enriquewph/Impresora-Braille/Documentacion/Imagenes/IMG_20190517_113228.jpg

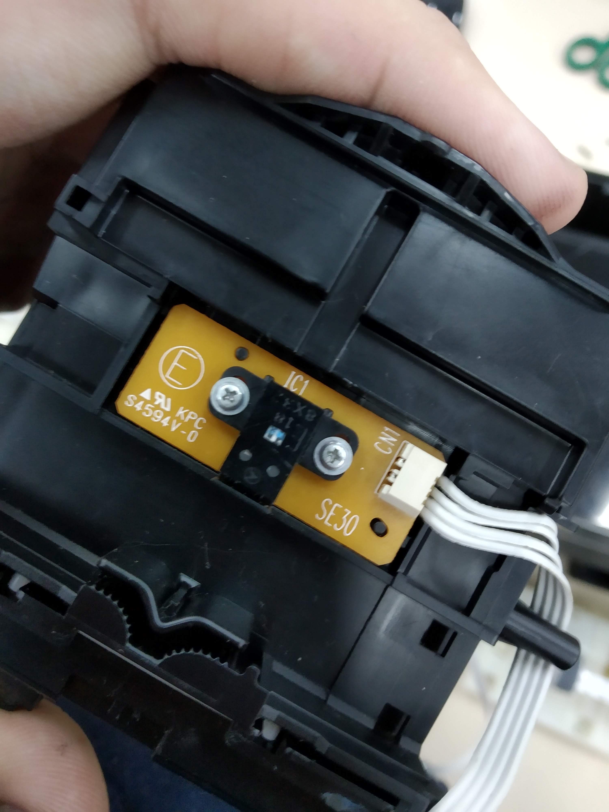
Documentacion/Imagenes/IMG_20190517_113228.jpg
