enriquewph/Impresora-Braille/Documentacion/Imagenes/IMG_20190517_133737.jpg

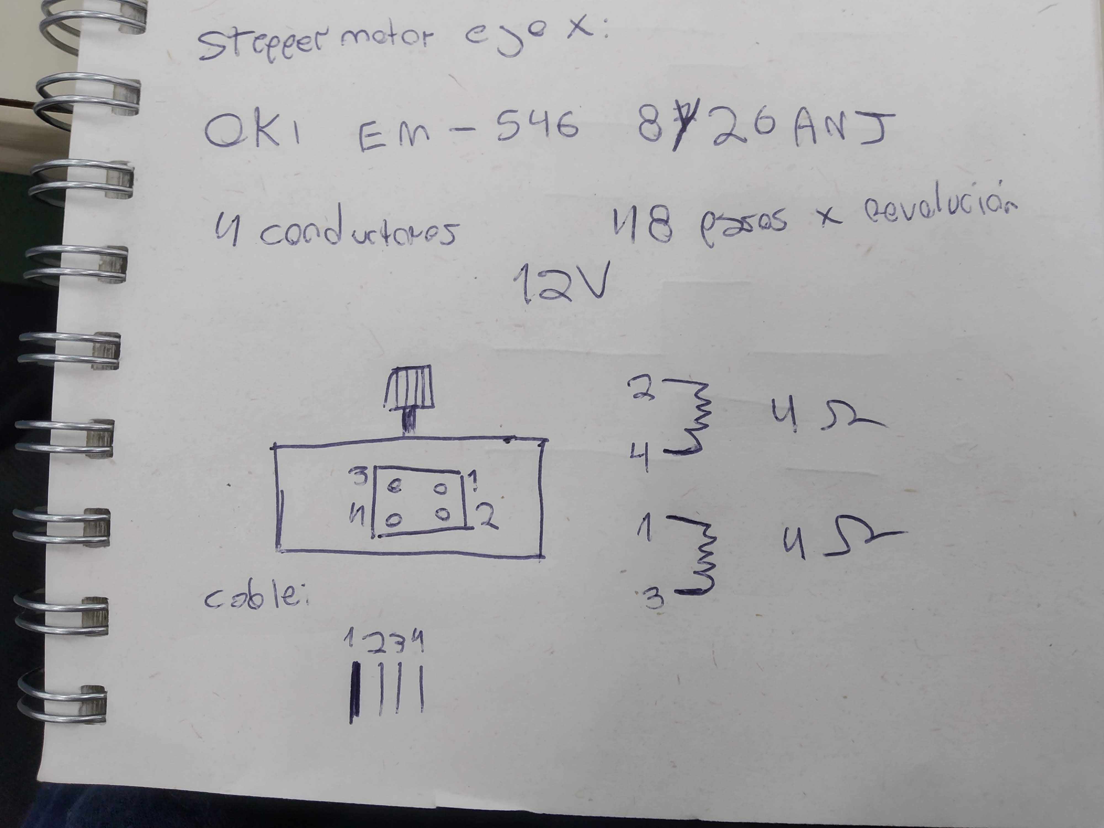
Documentacion/Imagenes/IMG_20190517_133737.jpg
