enriquewph/Impresora-Braille/Documentacion/Jerarquias Programa.docx

Comunicación (WIFI, USB, BT, SD, etc)
Procesamiento de comandos
Instrucciones para ejecucion de movimientos
Interfaz de motores, sensores y actuadores
Arduino
RTOS

1
Edicion de texto no - braille
Vista previa de traducción
2
Traduccion definitiva
Edicion del texto traducido.
3
Generar documento tipo PDF.
Procesar PDF, generar matriz de puntos.
4
Vista previa del documento
Conexion e impresión
