enriquewph/Impresora-Braille/Electronica/revision_fuentesw.pdf

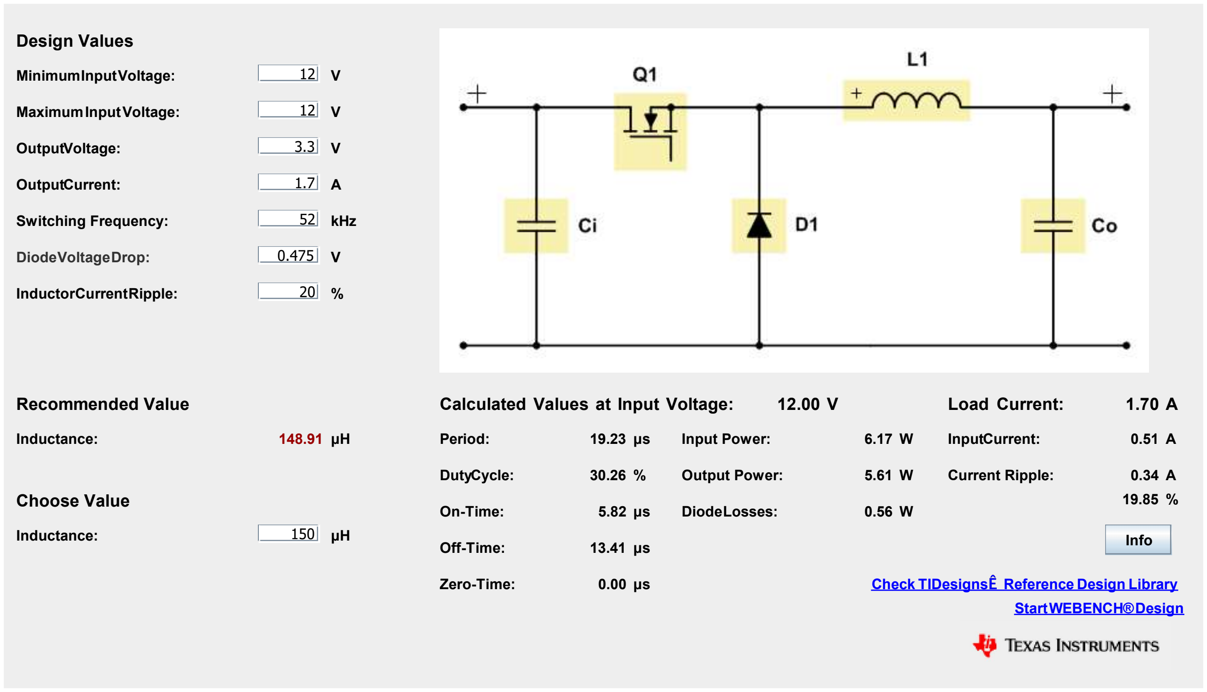
[picture p3: figure]
Load Current:; Start WEBENCH® Design; Info; Current Ripple:; Period:; InputCurrent:; Calculated Values at Input Voltage:; 5.82 Diode Losses:; Input Power:; DutyCycle:; Output Power:; Zero-Time:; Off-Time:; On-Time:; Design Values; Diode Voltage Drop:; Choose Value; Inductance:; Recommended Value; 52 kHz; Inductor Current Ripple:; Switching Frequency:; OutputCurrent:; OutputVoltage:; Maximum Input Voltage:; Minimum Input Voltage:

## Check TIDesigns Reference Design Library

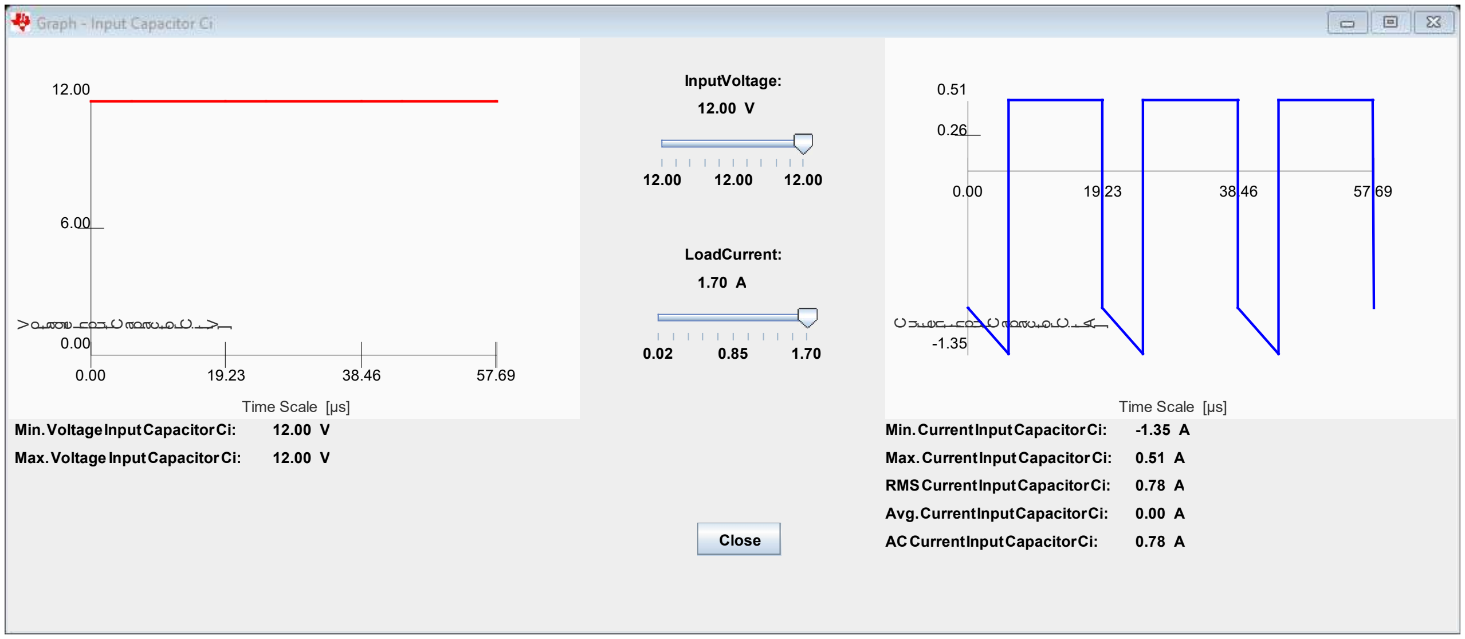
[picture p4: figure]
AC Current Input Capacitor Ci:; Avg. Current Input Capacitor Ci:; RMS Current Input Capacitor Ci:; Max. Current Input Capacitor Ci:; Min. Current Input Capacitor Ci:; Time Scale [μs] C u r; ito; Close; Max. Voltage Input Capacitor Ci:; Min. Voltage Input Capacitor Ci:; LoadCurrent:; InputVoltage:; Time Scale [μs] V o; lta

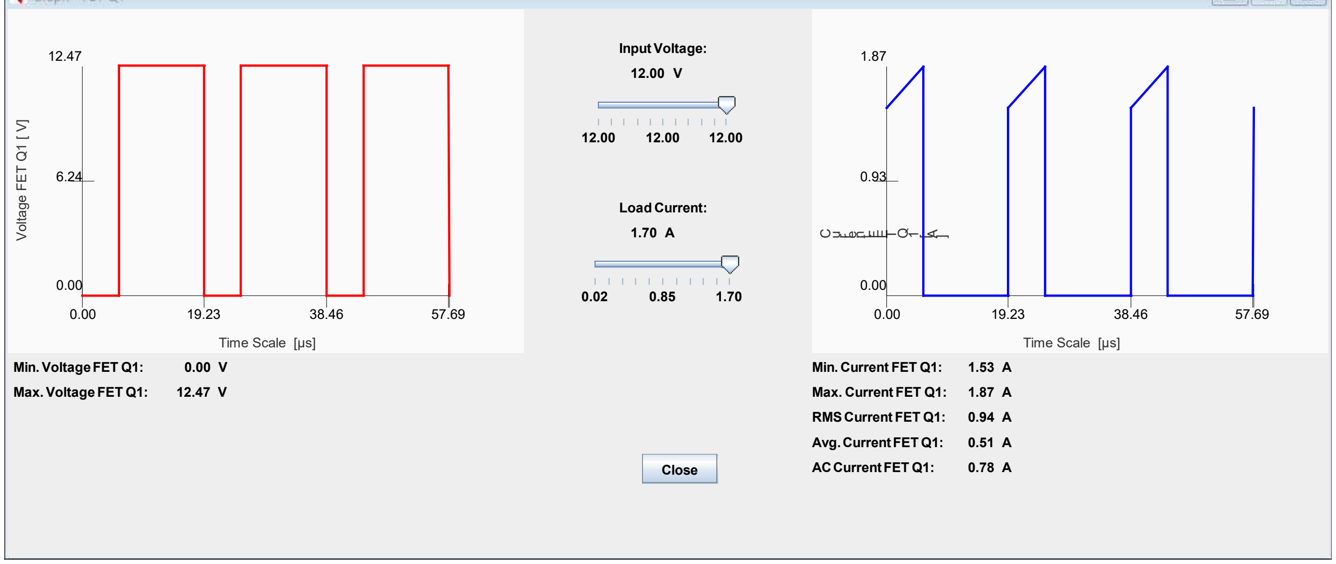
[picture p5: figure]
AC Current FET Q1:; Avg. Current FET Q1:; RMS Current FET Q1:; Max. Current FET Q1:; Min. Current FET Q1:; Time Scale [μs] C u r; tFE; Close; Max. Voltage FET Q1:; Min. Voltage FET Q1:; Load Current:; Input Voltage:; Time Scale [μs] Voltage FET Q¹ [ V]

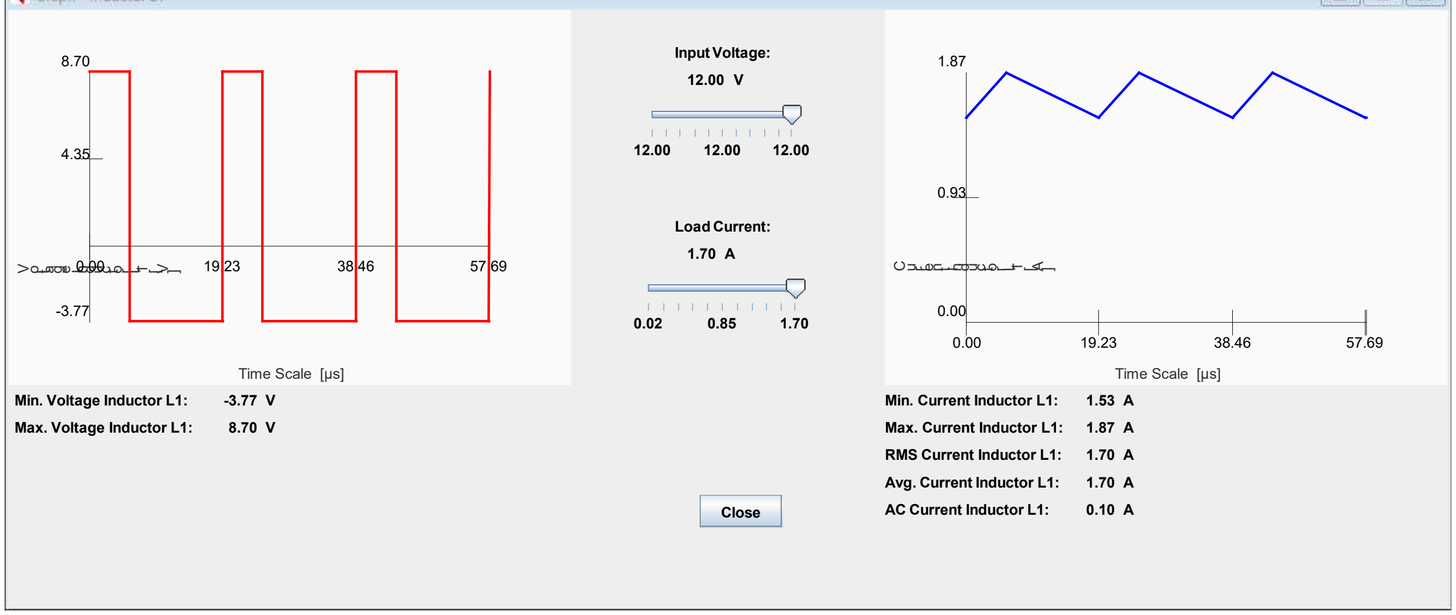
[picture p6: figure]
AC Current Inductor L1:; Avg. Current Inductor L1:; RMS Current Inductor L1:; Max. Current Inductor L1:; Min. Current Inductor L1:; Time Scale [μs] C u r; Close; Max. Voltage Inductor L1:; Min. Voltage Inductor L1:; Load Current:; Input Voltage:; Time Scale [μs] V o; lta

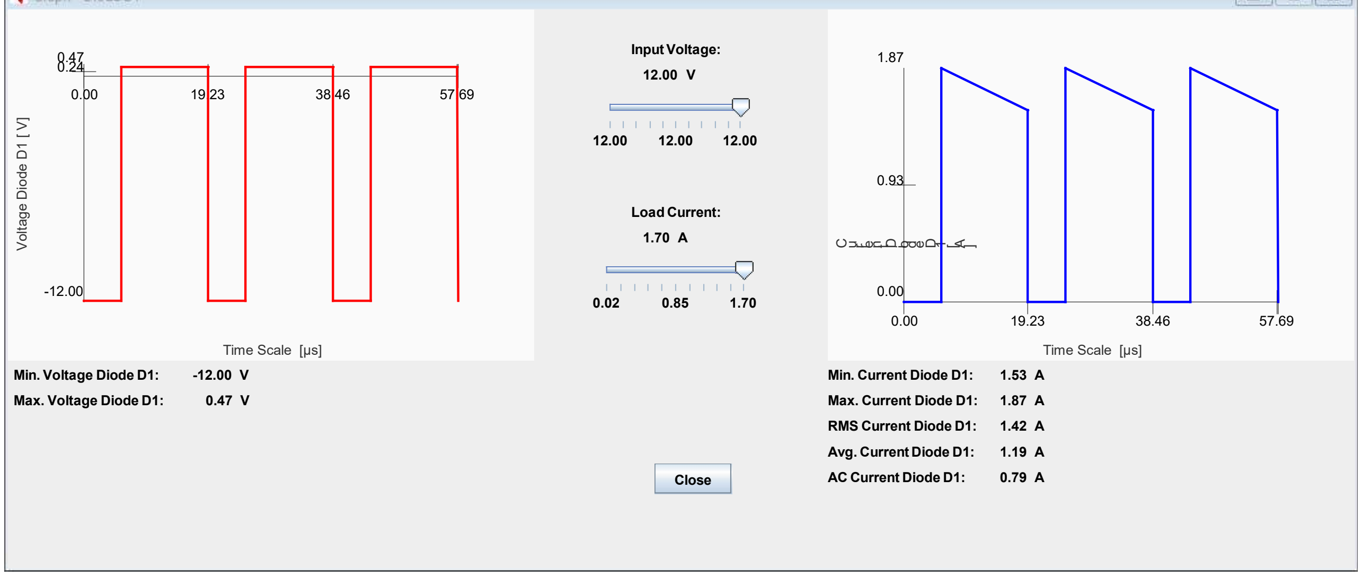
[picture p7: figure]
AC Current Diode D1:; Avg. Current Diode D1:; RMS Current Diode D1:; Max. Current Diode D1:; Min. Current Diode D1:; Time Scale [μs] C u r; Close; Max. Voltage Diode D1:; Min. Voltage Diode D1:; Load Current:; Input Voltage:; Time Scale [μs] Voltage Diode D¹ [ V]

### 97.43 mA

-168.76 mA
168.76 mA

### 0.00 mA

### 97.43 mA

AC Current Output Capacitor Co:

Avg. Current Output Capacitor Co:

RMS Current Output Capacitor Co:

Max. Current Output Capacitor Co:

Min. Current Output Capacitor Co:

Time Scale [μs] Current Output Capacitor Co [ mA] | 0.00 | 19.23 | 38.46 | 57.69

84.38

168.76

-168.76

Close

### 3.30 V

### 3.30 V

Max. Voltage Output Capacitor Co:

Min. Voltage Output Capacitor Co:

Load Current:
1.70

A

0.02 | 0.85 | 1.70

Input Voltage:
12.00

V

12.00 | 12.00 | 12.00

Time Scale [μs] Voltage Output Capacitor Co [ V]

0.00 | 19.23 | 38.46 | 57.69

1.65

3.30

0.00
