enriquewph/Impresora-Braille/Electronica/links.txt

El desarrollo electronico se hace en EASYEDA. en el siguiente proyecto:
https://easyeda.com/quique18c/impresora-braille-2019
