enriquewph/Impresora-Braille/Documentacion/Diagramas de diseño/Diagrama de diseño.pptx

Diagrama de transición de estados

## Slide 2

Diagrama de Flujos

INICIO

Recibir Hoja
