enriquewph/Impresora-Braille/Documentacion/Diagramas de diseño/casos de uso.pdf

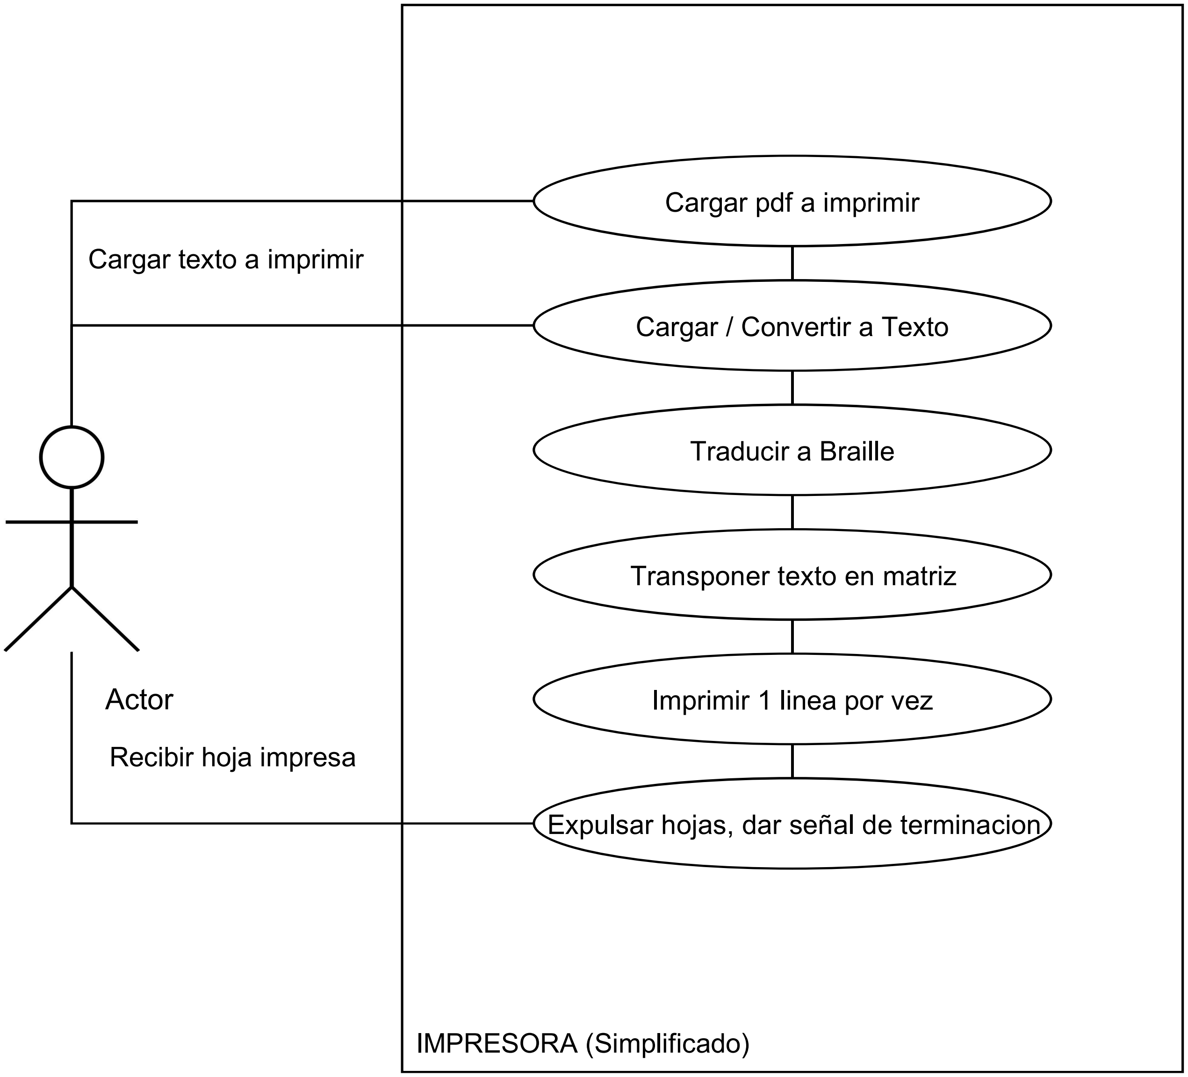
[picture p8: figure]
IMPRESORA (Simplificado); Cargar pdf a imprimir; Cargar / Convertir a Texto; Transponer texto en matriz; Imprimir 1 linea por vez; Traducir a Braille; Actor; Cargar texto a imprimir; Recibir hoja impresa

Expulsar hojas, dar señal de terminacion

# casos de uso
