enriquewph/Impresora-Braille/Documentacion/Diagramas de diseño/diagrama de estados.pdf

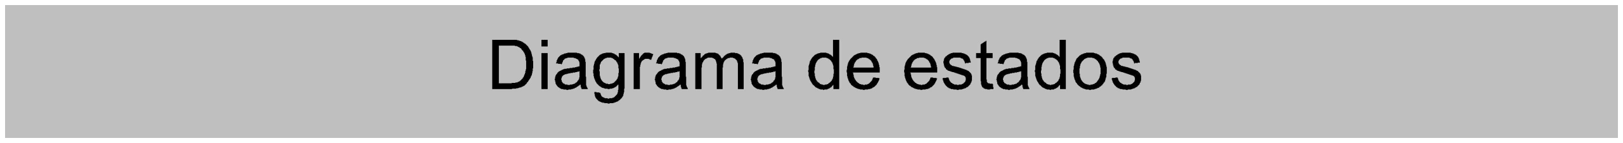
[picture p9: figure]
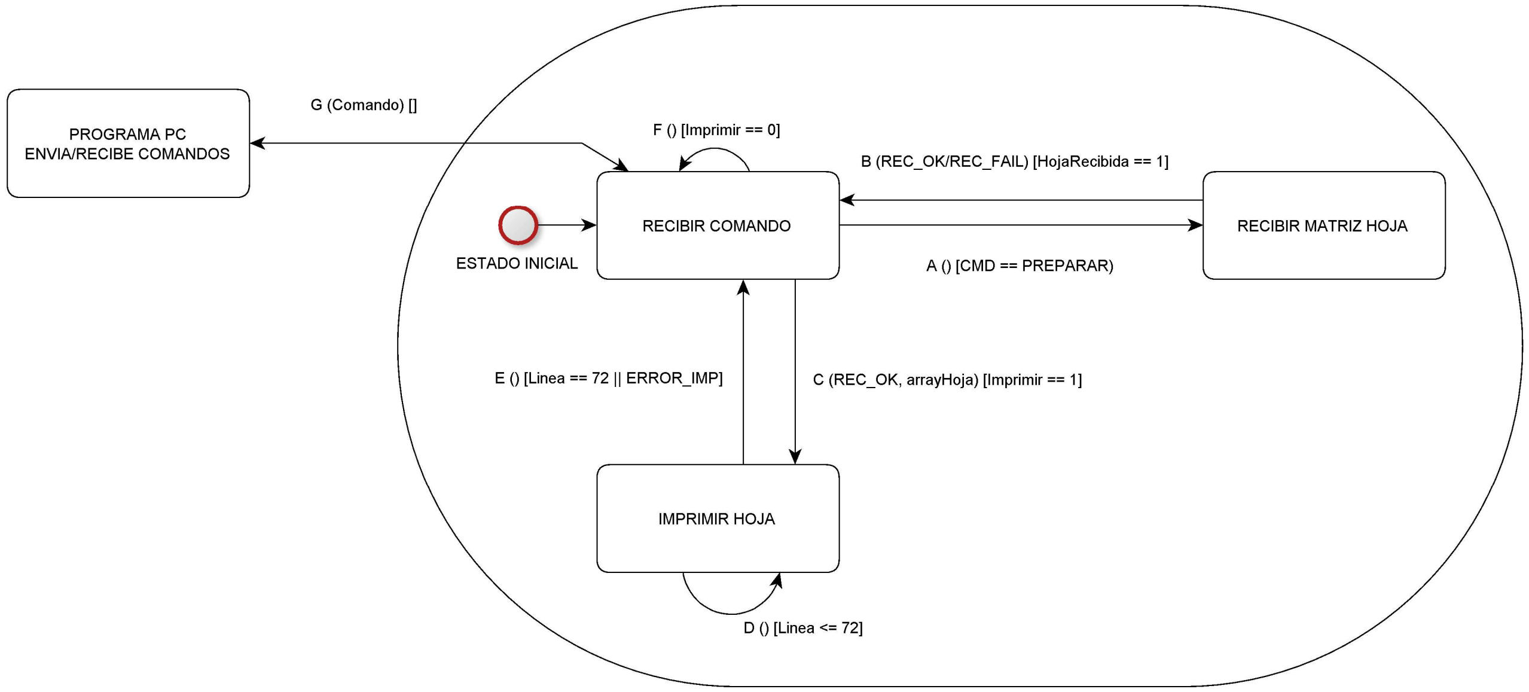
[picture p10: figure]
