enriquewph/Impresora-Braille/Documentacion/Diagramas de diseño/diagrama de flujos.pdf

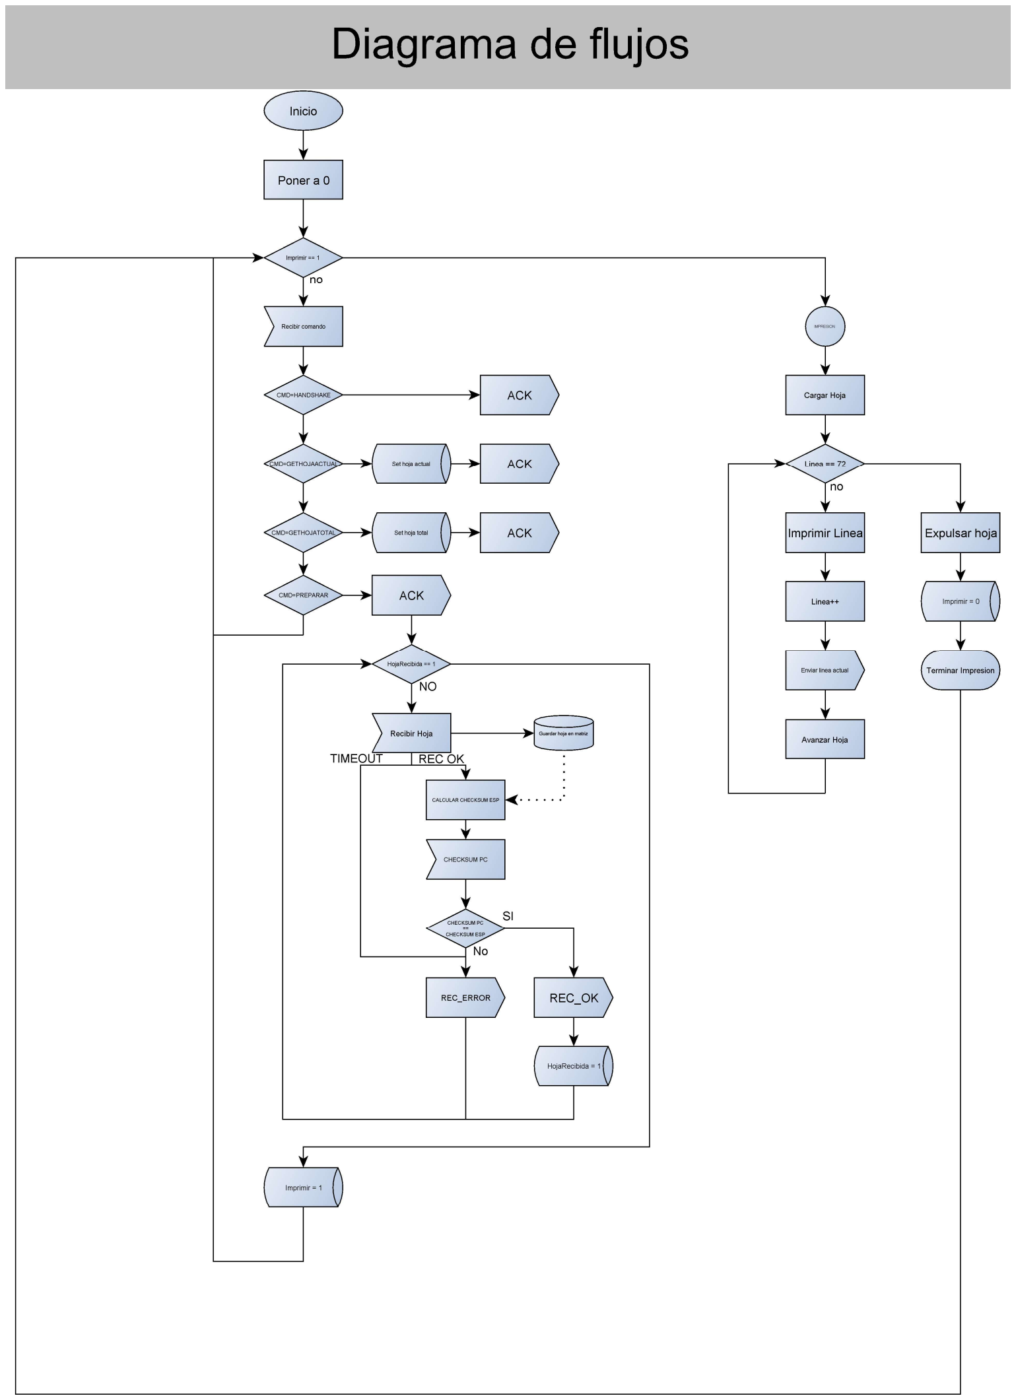
[picture p11: page 1]
