enriquewph/Impresora-Braille/Documentacion/Diseños Graficos/GD Informe/c622d8ba-e4e6-400b-8f1a-ba454055652d.png

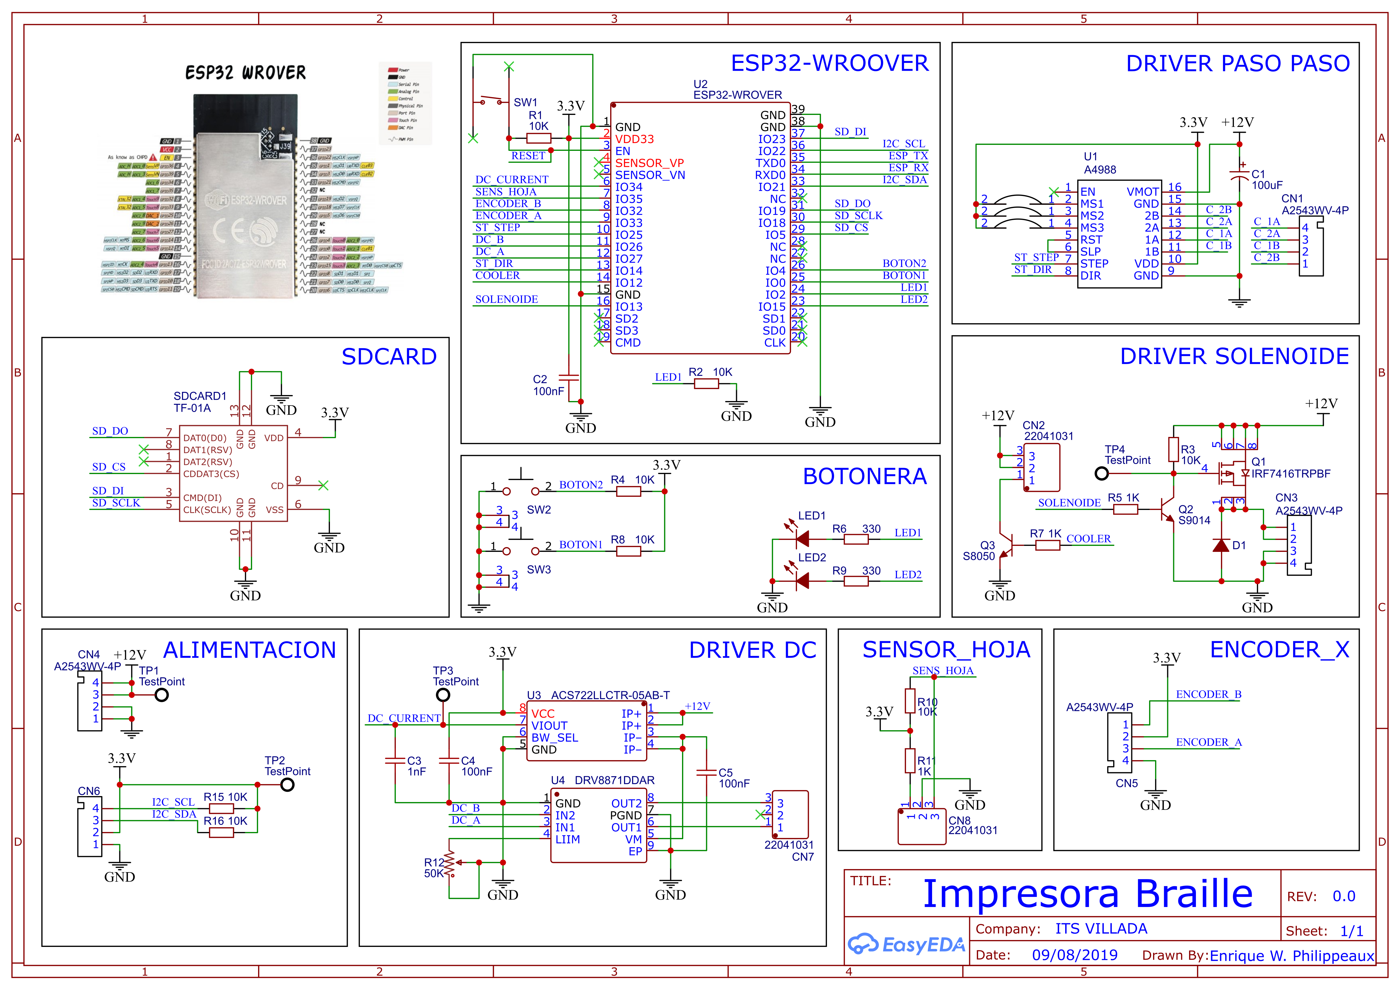
Documentacion/Diseños Graficos/GD Informe/c622d8ba-e4e6-400b-8f1a-ba454055652d.png
