enriquewph/Impresora-Braille/Documentacion/Diseños Graficos/GD Informe/PCB_pcb_20191203164205.png

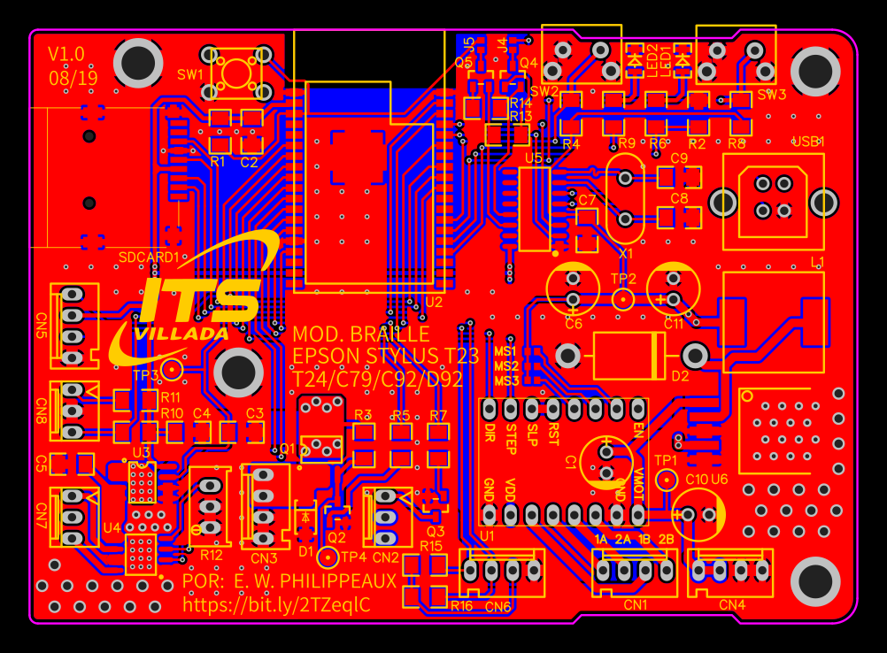
Documentacion/Diseños Graficos/GD Informe/PCB_pcb_20191203164205.png
