enriquewph/Impresora-Braille/Documentacion/Diseños Graficos/GD Informe/PCB_pcb_20191203164240.png

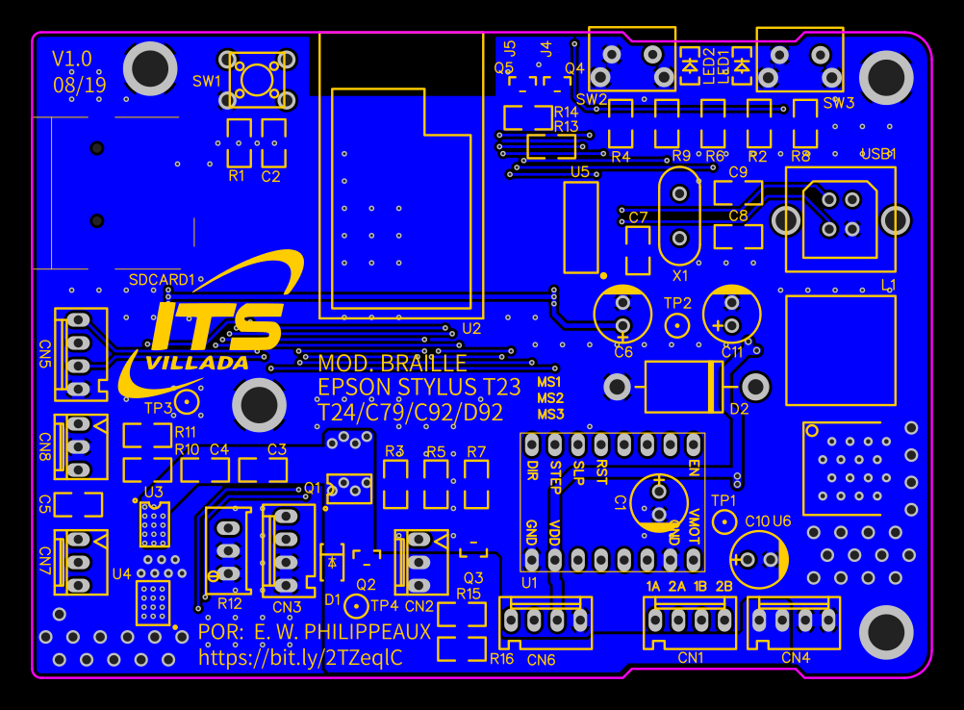
Documentacion/Diseños Graficos/GD Informe/PCB_pcb_20191203164240.png
