enriquewph/Impresora-Braille/Documentacion/Diseños Graficos/GD Informe/Photo View.png

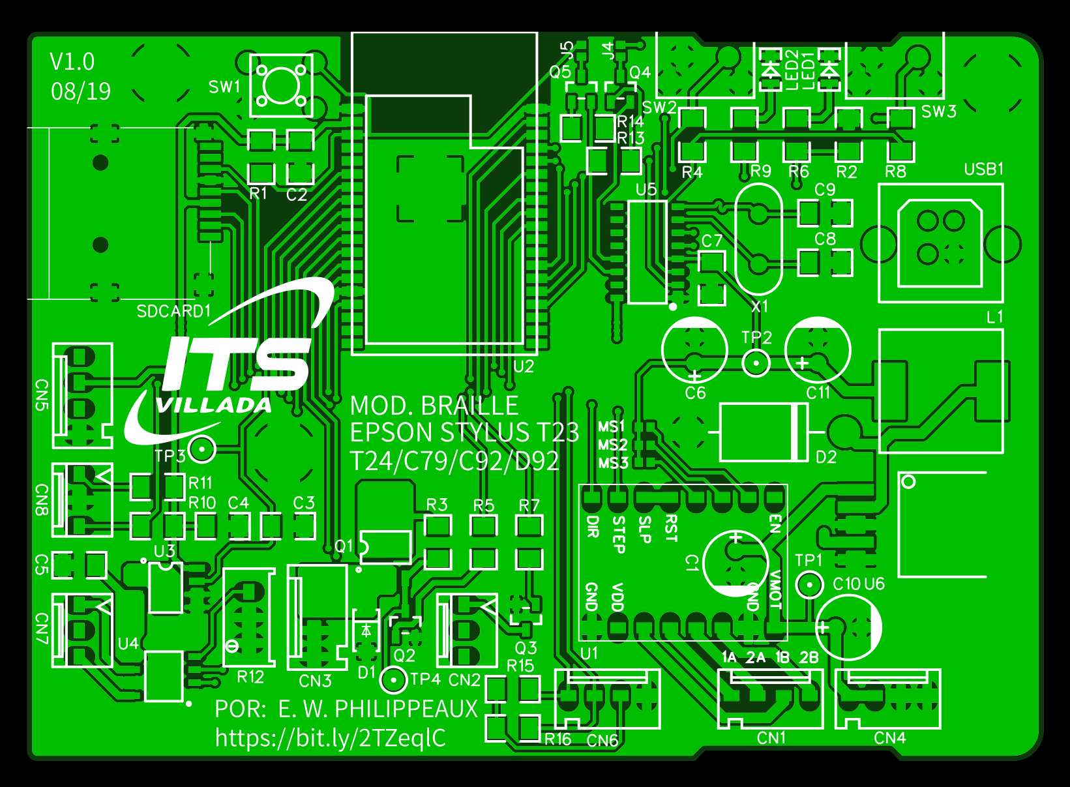
Documentacion/Diseños Graficos/GD Informe/Photo View.png
