enriquewph/Impresora-Braille/Documentacion/Diseños Graficos/GD Informe/rect6.png

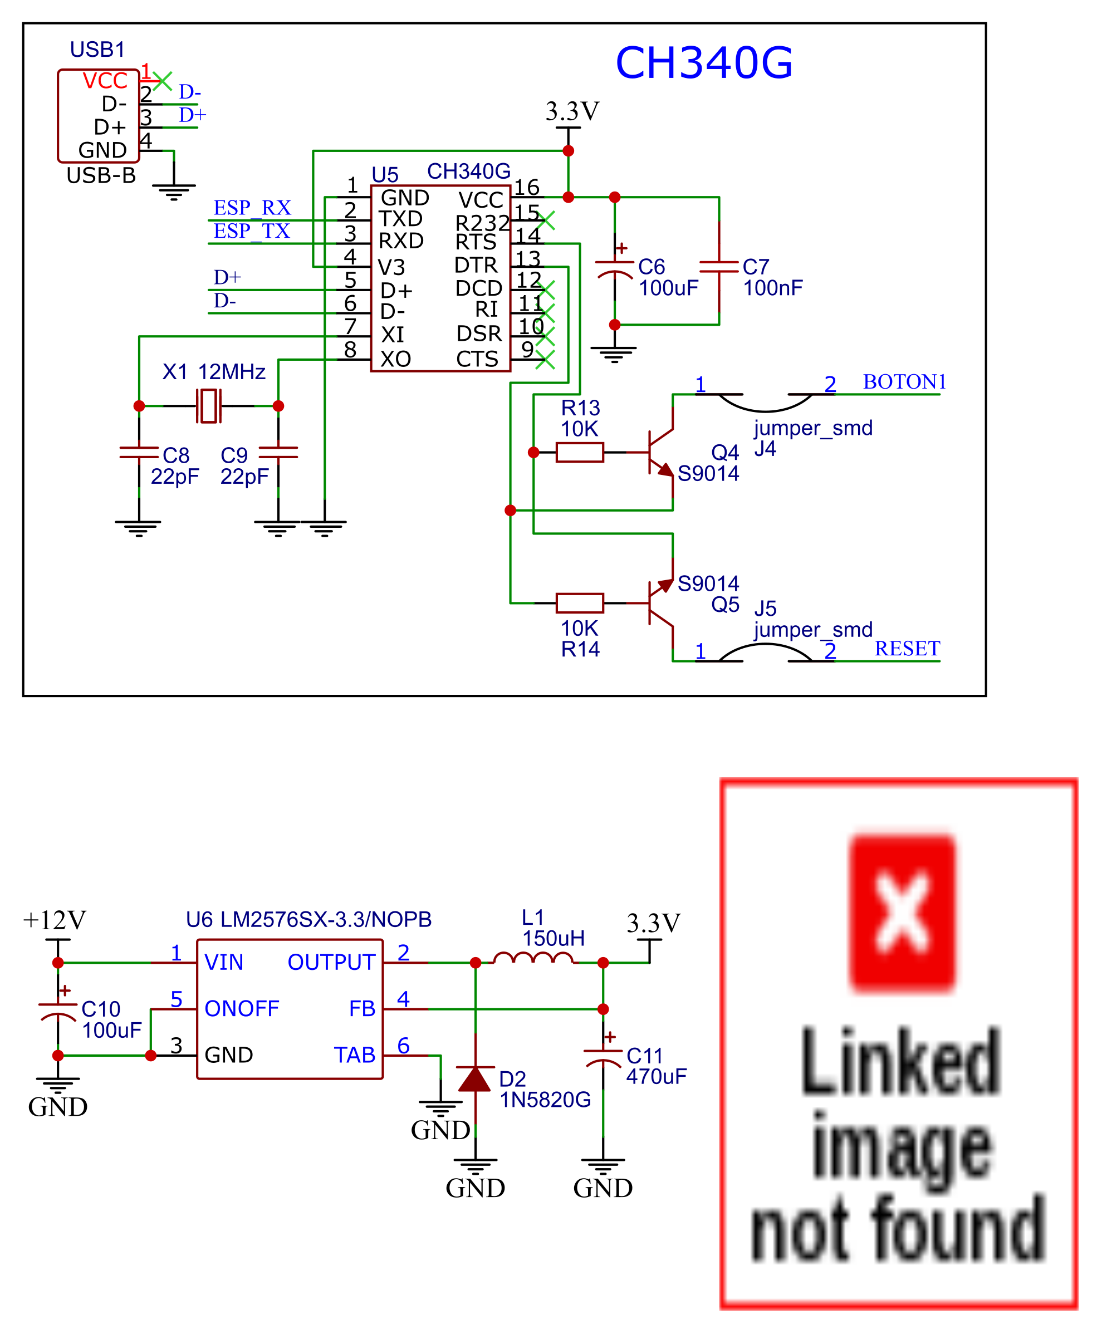
Documentacion/Diseños Graficos/GD Informe/rect6.png
