enriquewph/Impresora-Braille/Documentacion/Diseños Graficos/QR_GITHUB.png

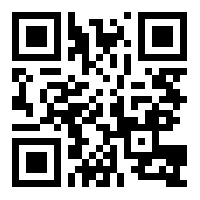
Documentacion/Diseños Graficos/QR_GITHUB.png
