enriquewph/Impresora-Braille/Documentacion/Diseños Graficos/repository-open-graph-template.png

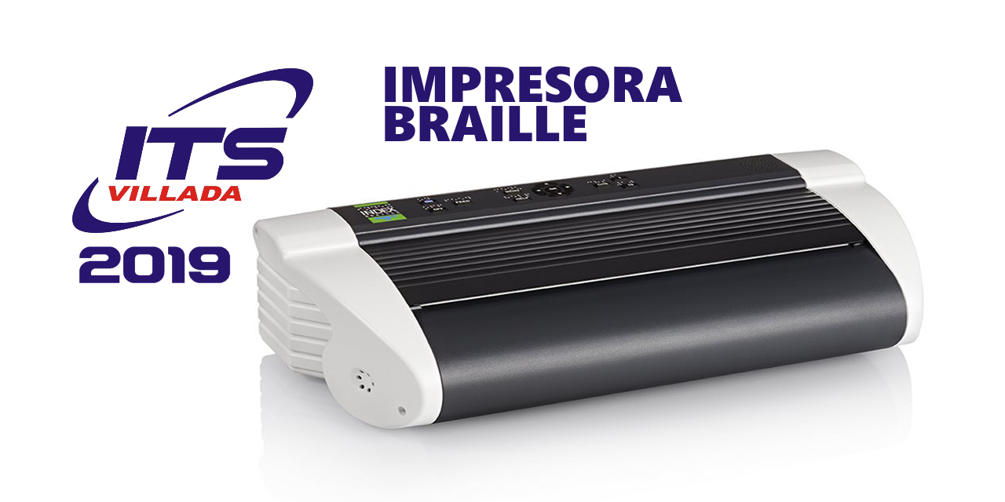
Documentacion/Diseños Graficos/repository-open-graph-template.png
