enriquewph/Impresora-Braille/Documentacion/Diseños Graficos/text4713-w.png

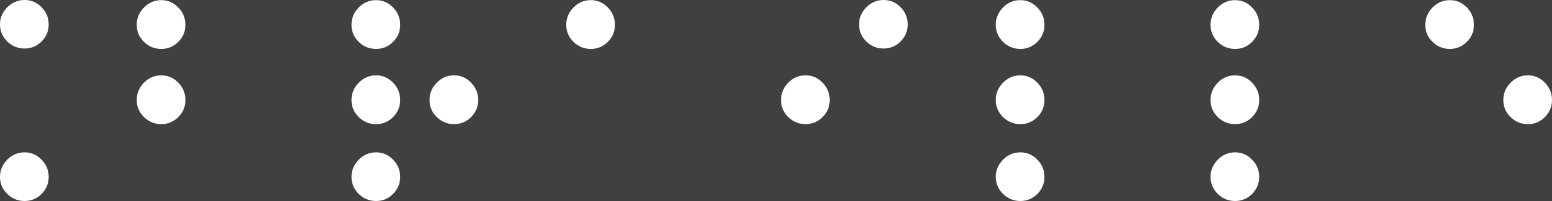
Documentacion/Diseños Graficos/text4713-w.png
