enriquewph/Impresora-Braille/Documentacion/Diseños Graficos/text4713.png

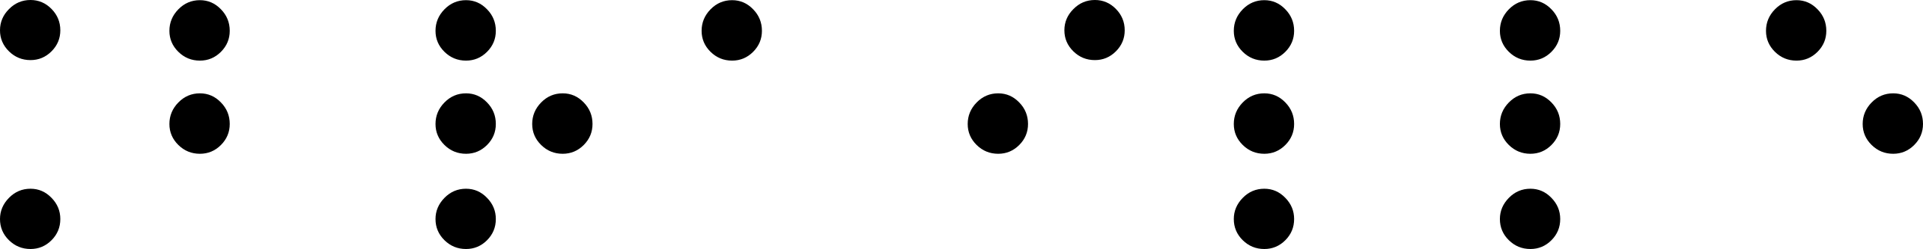
Documentacion/Diseños Graficos/text4713.png
