enriquewph/Impresora-Braille/Documentacion/Documentos Técnicos Signografía Braille/275px-Braille_code_dimensions.jpg

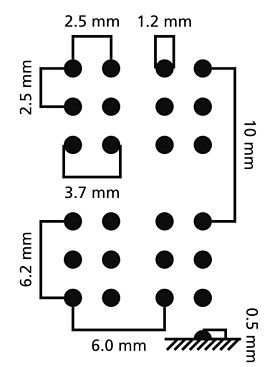
Documentacion/Documentos Técnicos Signografía Braille/275px-Braille_code_dimensions.jpg
