enriquewph/Impresora-Braille/Documentacion/Imagenes/IMG_20190517_100155.jpg

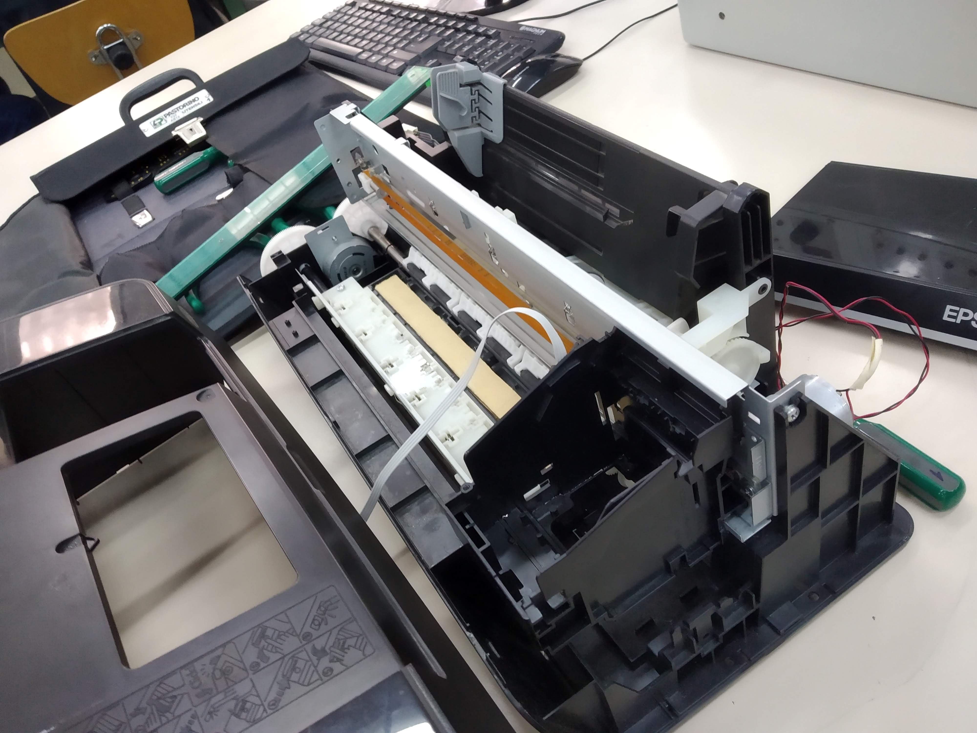
Documentacion/Imagenes/IMG_20190517_100155.jpg
