enriquewph/Impresora-Braille/Documentacion/Imagenes/IMG_20190517_100206.jpg

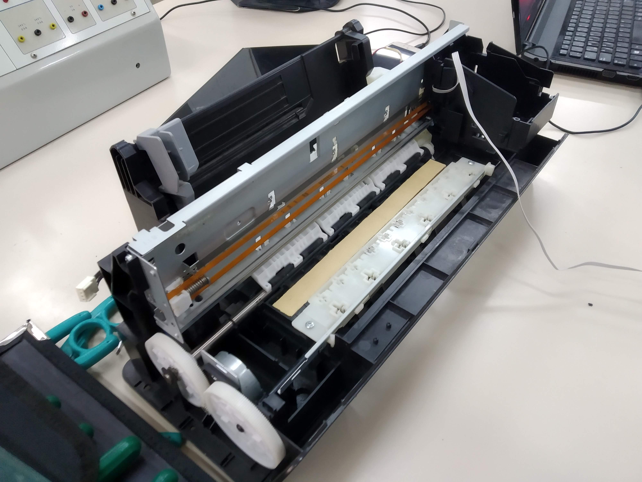
Documentacion/Imagenes/IMG_20190517_100206.jpg
