enriquewph/Impresora-Braille/Documentacion/Imagenes/IMG_20190517_100211.jpg

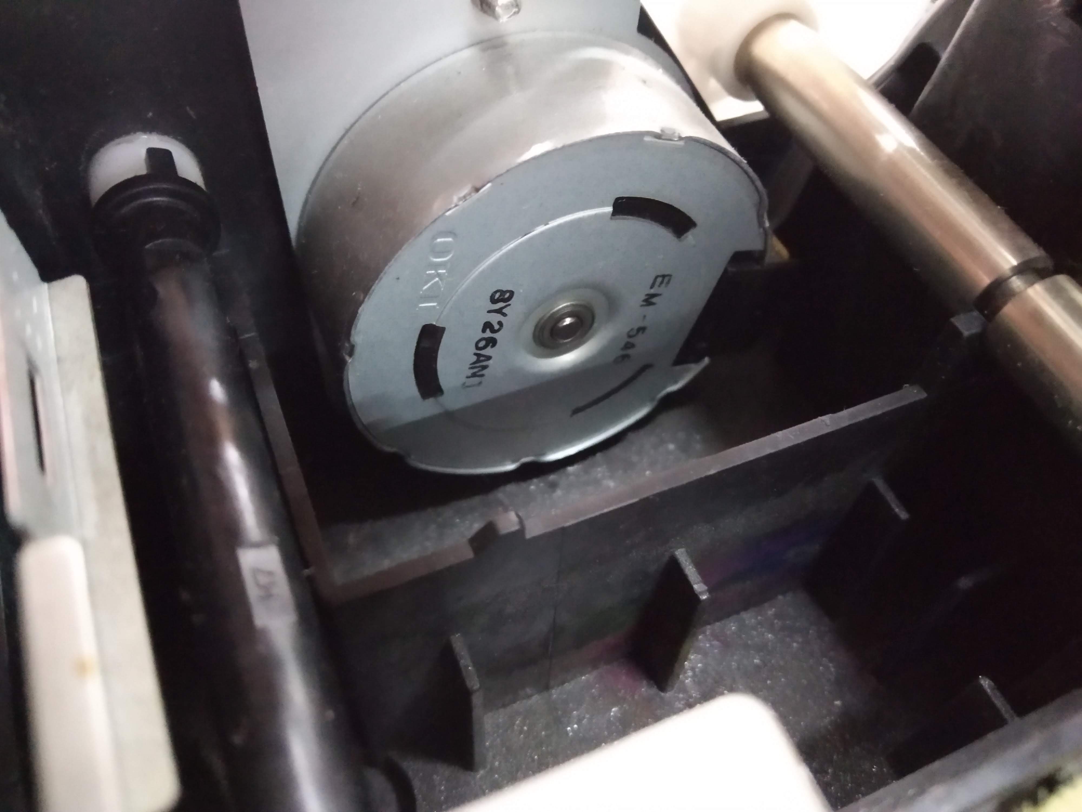
Documentacion/Imagenes/IMG_20190517_100211.jpg
