enriquewph/Impresora-Braille/Documentacion/Imagenes/IMG_20190517_100216.jpg

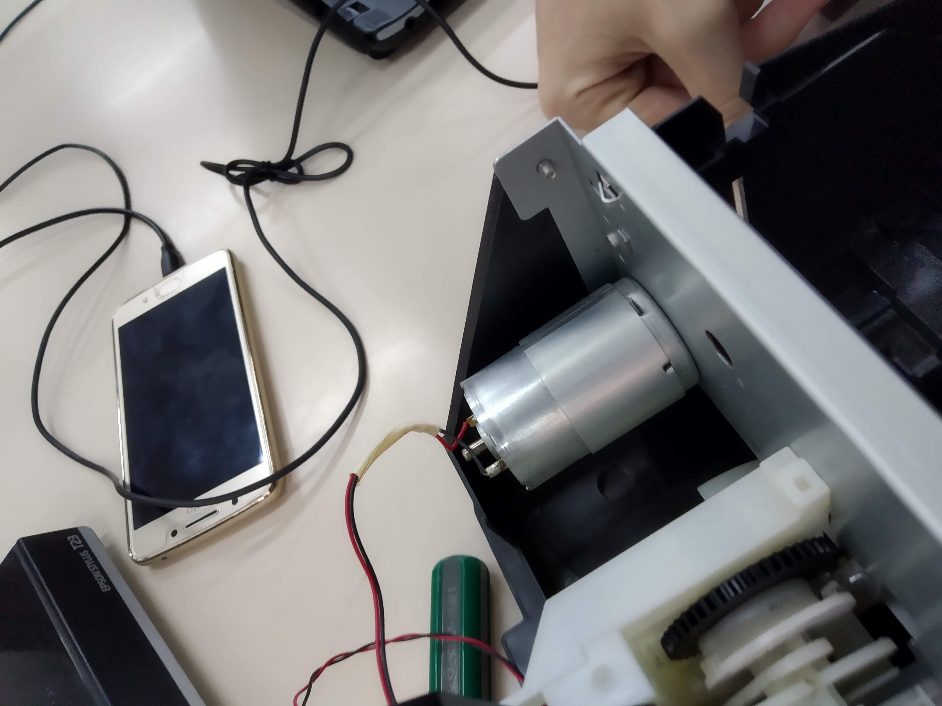
Documentacion/Imagenes/IMG_20190517_100216.jpg
