enriquewph/Impresora-Braille/Documentacion/Imagenes/IMG_20190517_133741.jpg

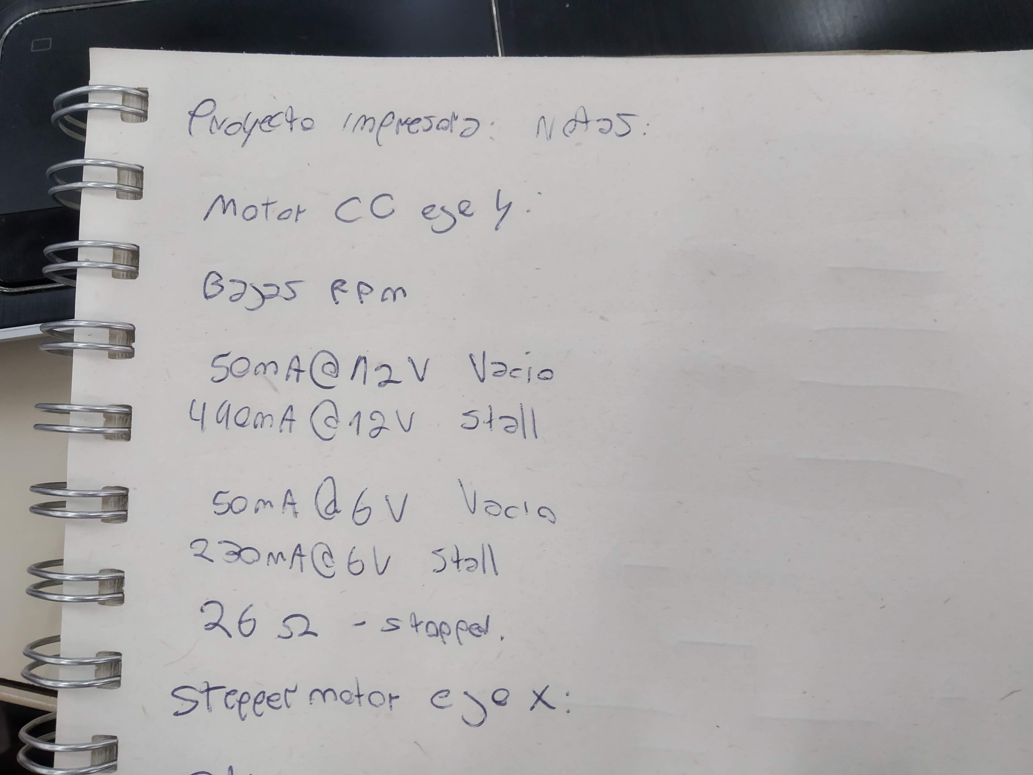
Documentacion/Imagenes/IMG_20190517_133741.jpg
