enriquewph/Impresora-Braille/Documentacion/Imagenes/IMG_20190517_133750.jpg

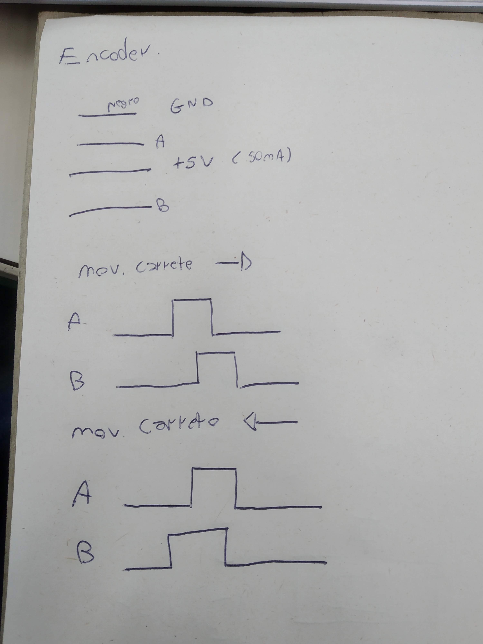
Documentacion/Imagenes/IMG_20190517_133750.jpg
