enriquewph/Impresora-Braille/Documentacion/Imagenes/IMG_20190614_114311.jpg

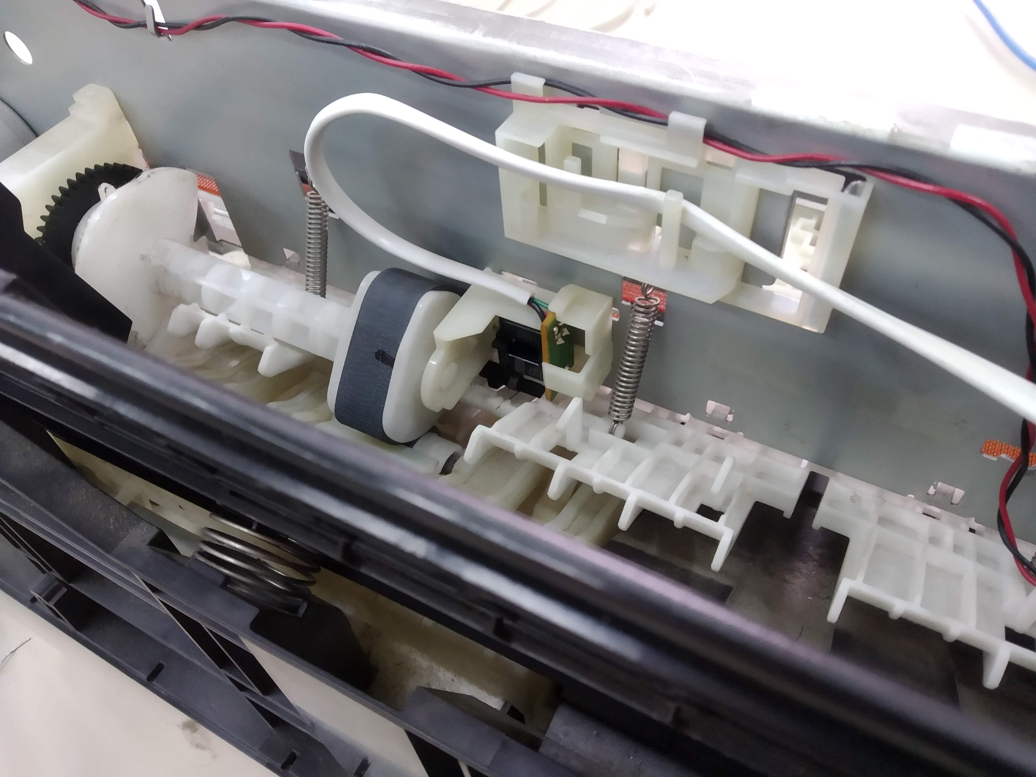
Documentacion/Imagenes/IMG_20190614_114311.jpg
