enriquewph/Impresora-Braille/Documentacion/Imagenes/IMG_20190614_114315.jpg

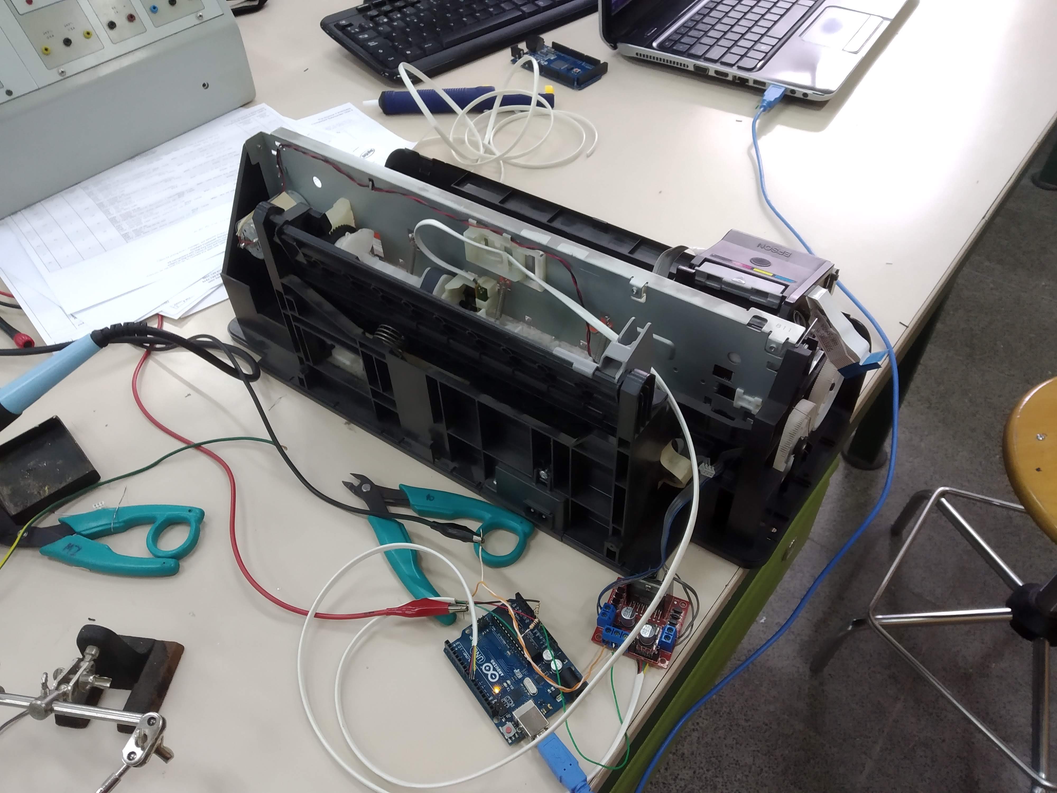
Documentacion/Imagenes/IMG_20190614_114315.jpg
