enriquewph/Impresora-Braille/Documentacion/Imagenes/IMG_20190614_114637.jpg

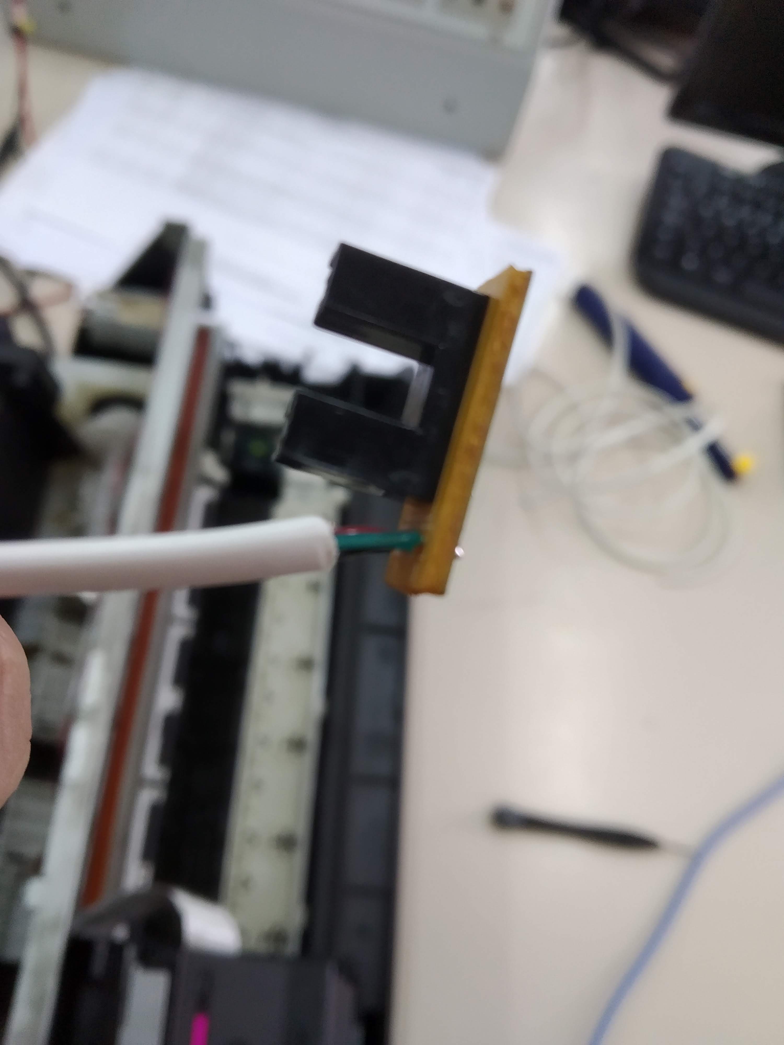
Documentacion/Imagenes/IMG_20190614_114637.jpg
