enriquewph/Impresora-Braille/Documentacion/Imagenes/IMG_20190614_114703.jpg

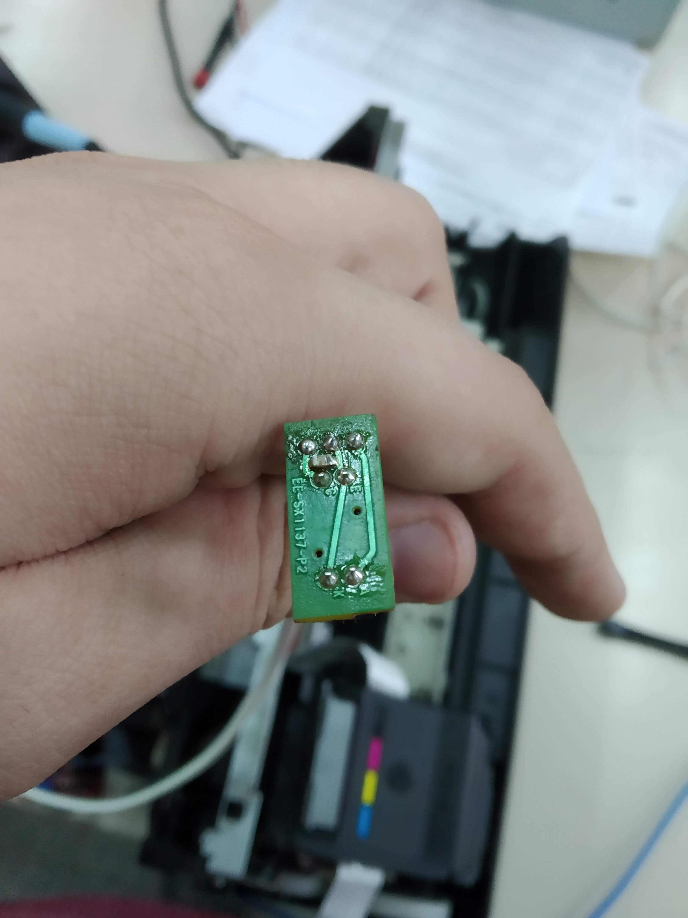
Documentacion/Imagenes/IMG_20190614_114703.jpg
