enriquewph/Impresora-Braille/Documentacion/Imagenes/IMG_20190614_114706.jpg

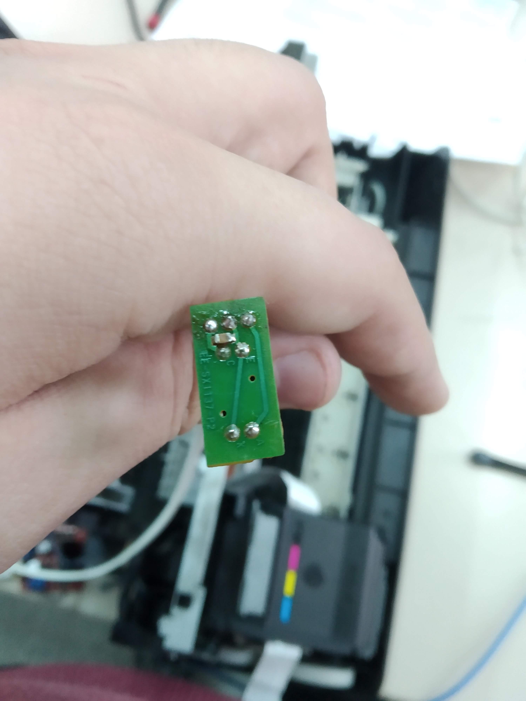
Documentacion/Imagenes/IMG_20190614_114706.jpg
