enriquewph/Impresora-Braille/Documentacion/Varios/flujos.jpg

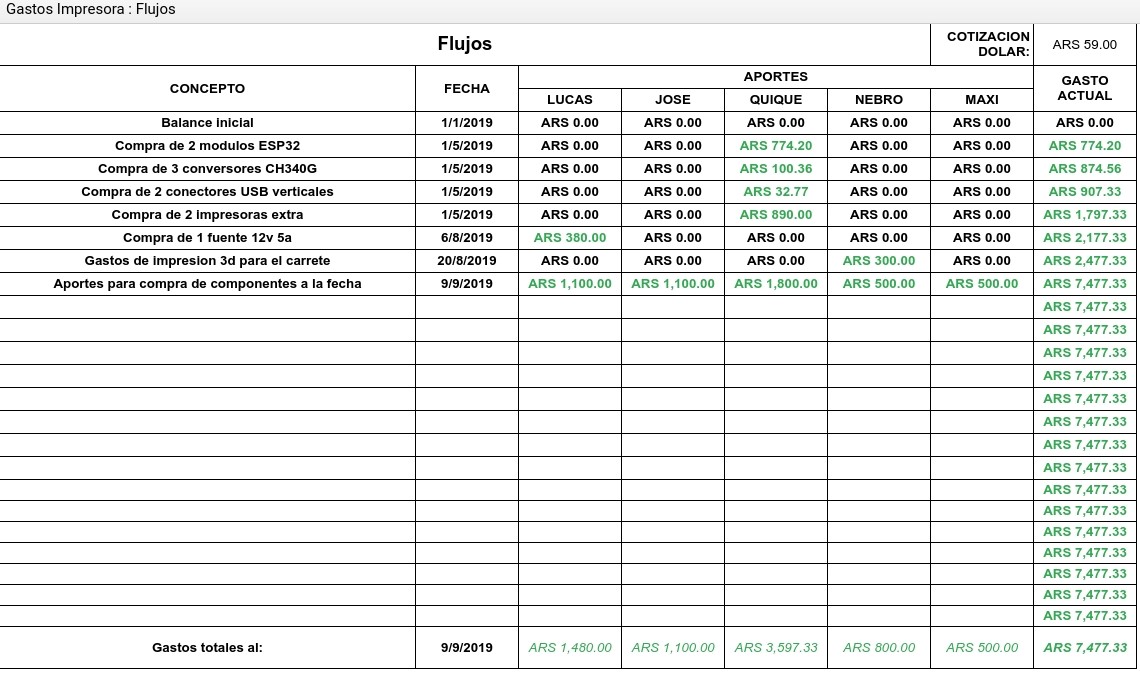
Documentacion/Varios/flujos.jpg
