enriquewph/Impresora-Braille/Documentacion/Varios/Q9846-0139_to_arduino.jpg

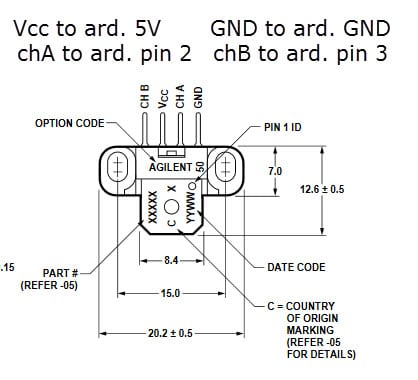
Documentacion/Varios/Q9846-0139_to_arduino.jpg
