enriquewph/Impresora-Braille/Documentacion/BOM_Impresora Braille 2019_20190827101217.csv

ID | Name | Designator | Footprint | Quantity | Manufacturer Part | Manufacturer | Supplier | Supplier Part | LCSC Assembly
1 | TF-01A | SDCARD1 | TF-01A | 1 | TF-01A | HRO | LCSC | C91145
2 | ESP32-WROVER | U2 | ESP32-WROVER | 1 | ESP32-WROVER | Espressif Systems | LCSC | C129145
3 | 100nF | C2,C4,C5,C7 | 1206 | 4 | CC1206KKX7R0BB104 | YAGEO | LCSC | C107181
4 | 10K | R8,R4,R3,R10,R1,R2,R15,R16,R13,R14 | 1206 | 10 | RTT061002FTP | RALEC | LCSC | C104595
5 | PTS645VL39-2LFS | SW3,SW2 | KEY-7.0*7.0 | 2 | PTS645VL39-2LFS | C&K | LCSC | C221891
6 | A4988 | U1 | A4988 DRIVER MOTOR | 1 | A4988
7 | 100uF | C1 | CAP-D6.3XF2.5 | 1 | 100uF 50V 6.3*12Black high frequency | ValuePro | LCSC | C47891
8 | M7_C95872 | D1 | DO-214AC_2PIN-L5.66-W2.80-R | 1 | M7 | MDD | LCSC | C95872 | Yes
9 | IRF7416TRPBF | Q1 | SOIC-8_150MIL | 1 | IRF7416TRPBF | IR | LCSC | C3000 | Yes
10 | S9014 | Q2,Q4,Q5 | SOT-23(SOT-23-3) | 3 | S9014LT1 (S9014 J6) | CJ | LCSC | C2148
11 | A2543WV-4P | CN4,CN5,CN1,CN3,CN6 | PH-4P-2.54 | 5 | A2543WV-4P | Changjiang Connectors | LCSC | C239364
12 | DRV8871DDAR | U4 | SO-8_EP | 1 | DRV8871DDAR | TI | LCSC | C75864 | Yes
13 | ACS722LLCTR-05AB-T | U3 | SOIC-8_150MIL | 1 | ACS722LLCTR-05AB-T | Allegro MicroSystems, LLC | LCSC | C116613 | Yes
14 | 50K | R12 | RES-ADJ-TH_3PIN-V-L9.50-W4.85-PITCH2.50 | 1 | 3296W-1-503 | Chengdu Guosheng Tech | LCSC | C118911
15 | 1nF | C3 | 1206 | 1 | 1206B102K202CT | Walsin Tech Corp | LCSC | C303946
16 | 22041031 | CN7,CN8,CN2 | 22041031 | 3 | 22041031 | MOLEX | LCSC | C293437
17 | 1K | R11,R7,R5 | 1206 | 3 | 1206W4F1001T5E | UniOhm | LCSC | C4410 | Yes
18 | TJ-S3216SW9TGLC2R-A5 | LED2,LED1 | LED-1206 | 2 | TJ-S3216SW9TGLC2R-A5 | TOGIALED | LCSC | C192674
19 | TSA061G90-250 | SW1 | KEY-TOUCH-DIP-6.0*6.0*H | 1 | TSA061G90-250 | BRIGHT | LCSC | C294505
20 | 330 | R6,R9 | 1206 | 2 | 1206W4F3300T5E | UniOhm | LCSC | C17930
21 | jumper_smd | J1,J2,J3,J4,J5 | JMP | 5
22 | S8050 | Q3 | SOT-23(SOT-23-3) | 1 | S8050 | CJ | LCSC | C2146 | Yes
23 | TestPoint | TP1,TP2,TP3,TP4 | TESTPOINT_2MM | 4
24 | 22pF | C9,C8 | 1206 | 2 | 1206CG220J500NT | FH | LCSC | C1896
25 | USB-BType interface female 180° | USB1 | USB-B-1 | 1 | USB-BType interface female 180° |  | LCSC | C26234
26 | 100uF | C6,C10 | CAP-D6.3XF2.5 | 2 | 100uF 16Vblack gold 6.3*5 | ValuePro | LCSC | C43817
27 | CH340G | U5 | SOIC-16_150MIL | 1 | CH340G | WCH | LCSC | C14267 | Yes
28 | 12MHz | X1 | OSC-49S-1 | 1 | X49SD12MSD2SC | YXC | LCSC | C16369
29 | 150uH | L1 | L-SMD-12X12X8MM | 1 | CDRH127/LDNP-151MC | Sumida | LCSC | C338769
30 | LM2576SX-3.3/NOPB | U6 | TO-263-5 | 1 | LM2576SX-3.3/NOPB | TI | LCSC | C14403 | Yes
31 | 470uF | C11 | CAP-TH_BD6.3-P2.50-D1.0-L-FD | 1 | 470uF 6.3VGreen high frequency 6.3*7 | ValuePro | LCSC | C43328
32 | 1N5820G | D2 | DO-201AD | 1 | 1N5820G | ON Semicon | LCSC | C95400
