enriquewph/Impresora-Braille/Mecanica/archivos ultimos/ss solenoide esamblaje.SLDPRT.SLDASM

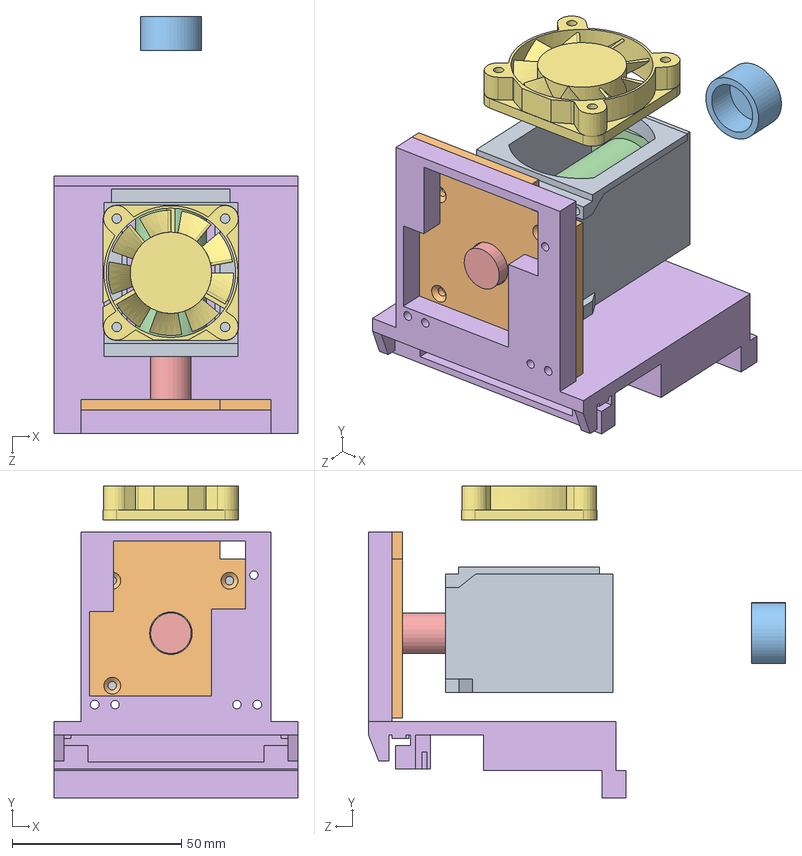
[picture p37: CAD file, 2019-08-08]
Mecanica/archivos ultimos/ss solenoide esamblaje.SLDPRT.SLDASM
72.0 x 92.0 x 123.1 mm
ss solenoide
Tapa impresora
TAPITA
solenoide
fan 40mm
