enriquewph/Impresora-Braille/Mecanica/impresora/Impresora asm.SLDASM

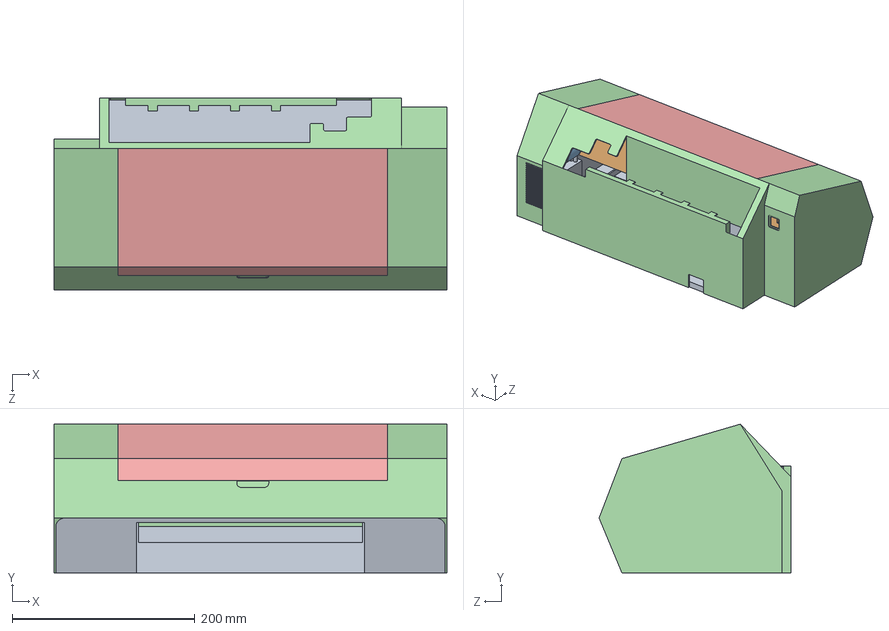
[picture p38: CAD file, 2019-08-08]
Mecanica/impresora/Impresora asm.SLDASM
430.0 x 162.7 x 210.0 mm
base
corredera
motor continua
Impresora cuerpo
ss solenoide
Tapa impresora
TAPITA
solenoide
punzon
soporte solenoide
Tornillo M3x5 x 4
fan 40mm
