enriquewph/Impresora-Braille/Desarrollo/Mecanica/Solenoide/Ensamblaje1.SLDASM

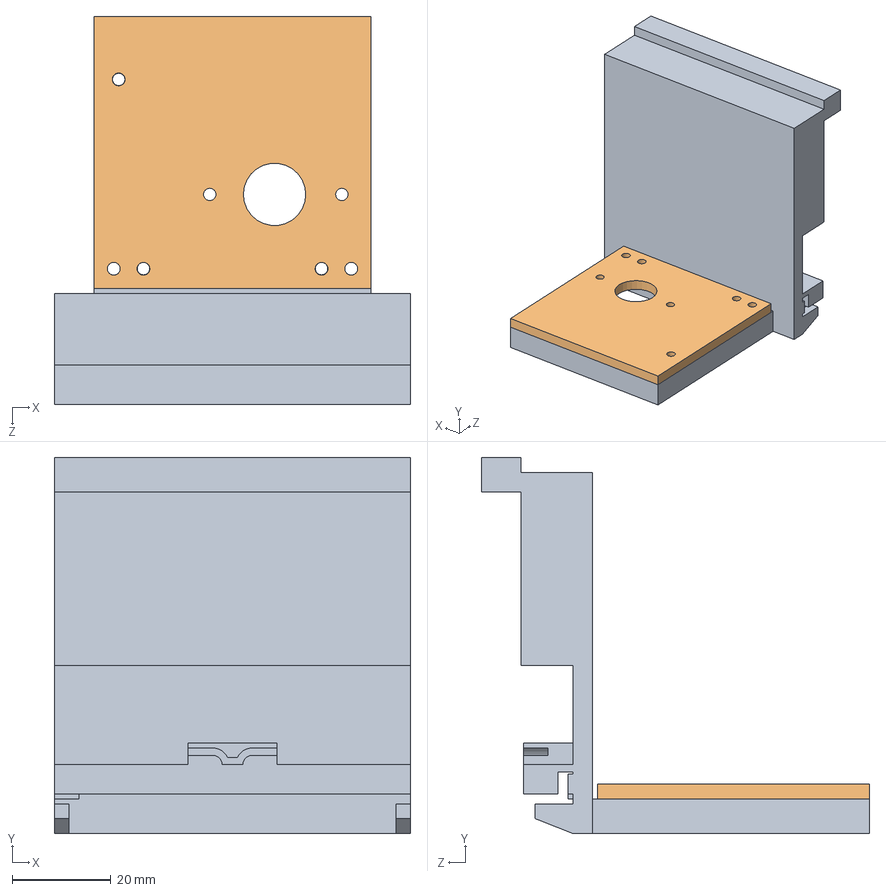
[picture p39: CAD file, 2019-07-30]
Desarrollo/Mecanica/Solenoide/Ensamblaje1.SLDASM
72.0 x 76.0 x 78.5 mm
Soporte solenoide
Tapa impresora
