enriquewph/Impresora-Braille/Mecanica/impresora/Ensamblaje1.SLDASM

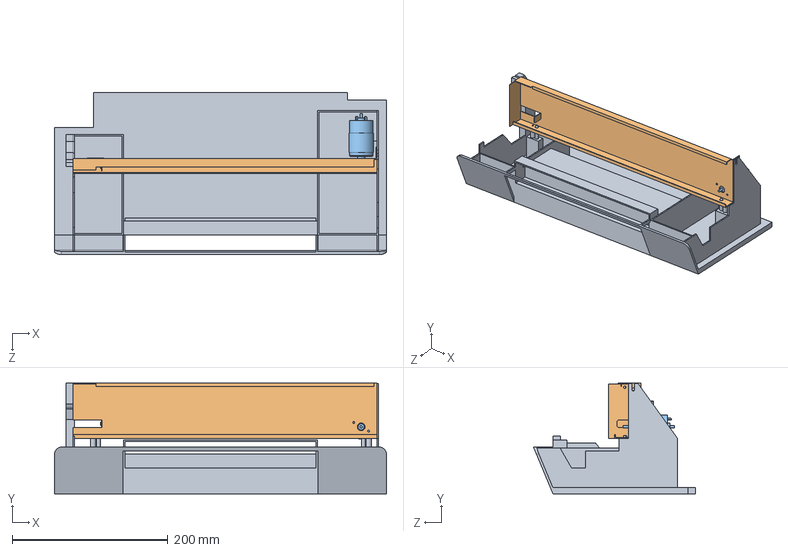
[picture p40: CAD file, 2019-08-08]
Mecanica/impresora/Ensamblaje1.SLDASM
426.0 x 142.0 x 208.0 mm
base
corredera
motor continua
