enriquewph/Impresora-Braille/Electronica/packagins 3d/tmc2100.step

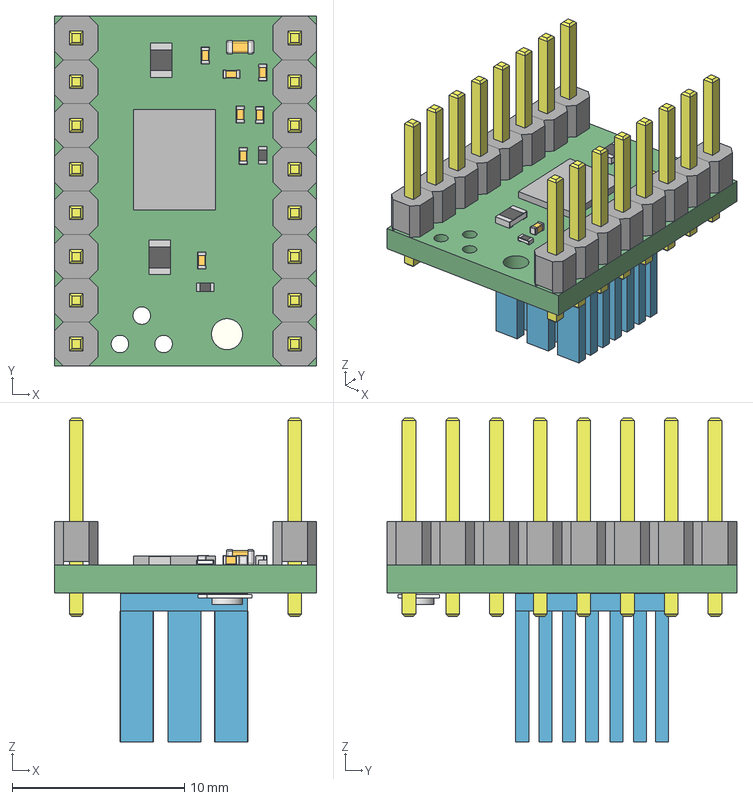
[picture p41: CAD file, 2019-08-08]
Electronica/packagins 3d/tmc2100.step
15.2 x 20.3 x 18.8 mm
Board
1x08 x 4
R0402 x 8
R0805 x 8
C0603 x 2
C0402 x 14
Extruded x 24
