enriquewph/Impresora-Braille/Electronica/pcb.step

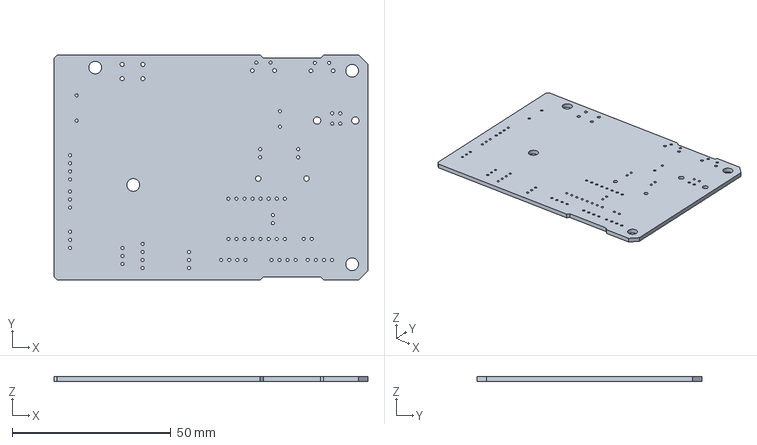
[picture p42: CAD file, 2019-08-24]
Electronica/pcb.step
99.0 x 71.0 x 1.69 mm
