enriquewph/Impresora-Braille/Mecanica/archivos ultimos/punta/agarre punta.SLDPRT

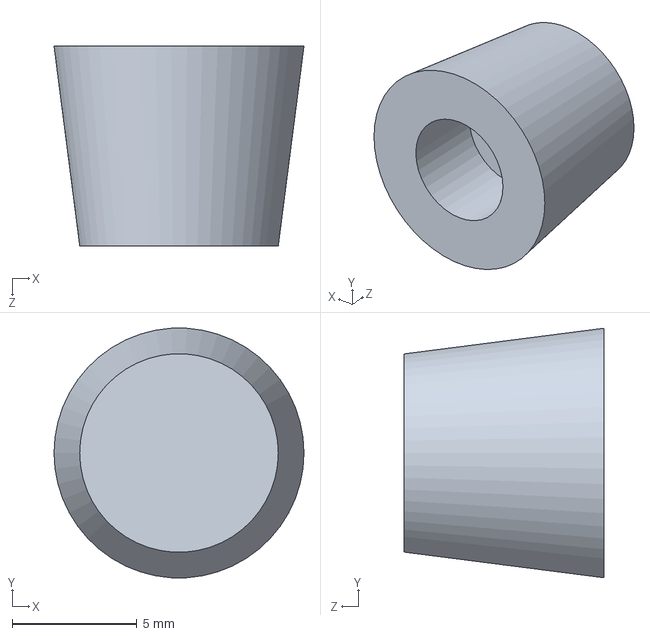
[picture p43: CAD file, 2019-08-08]
Mecanica/archivos ultimos/punta/agarre punta.SLDPRT
10.0 x 9.98 x 8.00 mm
