enriquewph/Impresora-Braille/Mecanica/archivos ultimos/ss solenoide.SLDPRT

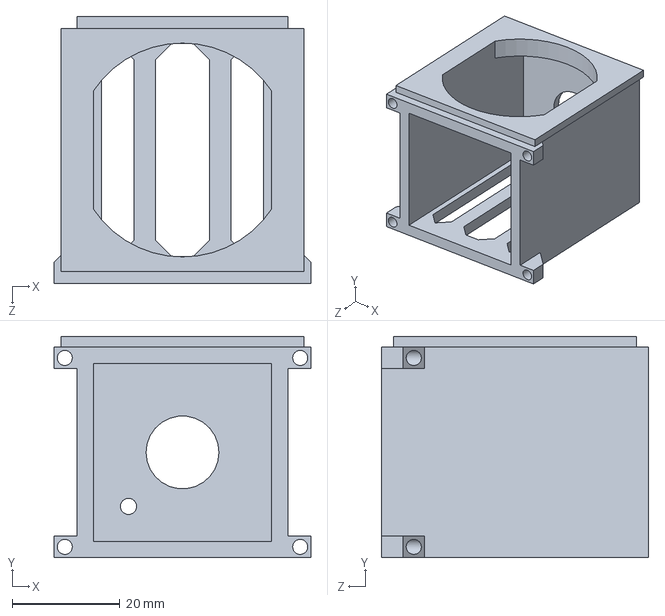
[picture p44: CAD file, 2019-08-24]
Mecanica/archivos ultimos/ss solenoide.SLDPRT
47.6 x 41.0 x 49.5 mm
