enriquewph/Impresora-Braille/Mecanica/impresora/corredera.SLDPRT

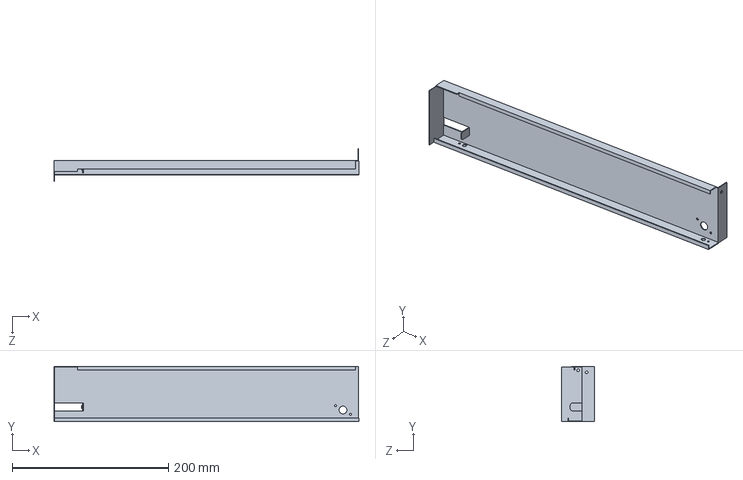
[picture p45: CAD file, 2019-08-08]
Mecanica/impresora/corredera.SLDPRT
390.5 x 71.0 x 42.0 mm
