enriquewph/Impresora-Braille/Mecanica/Motores/fan 40mm.SLDPRT

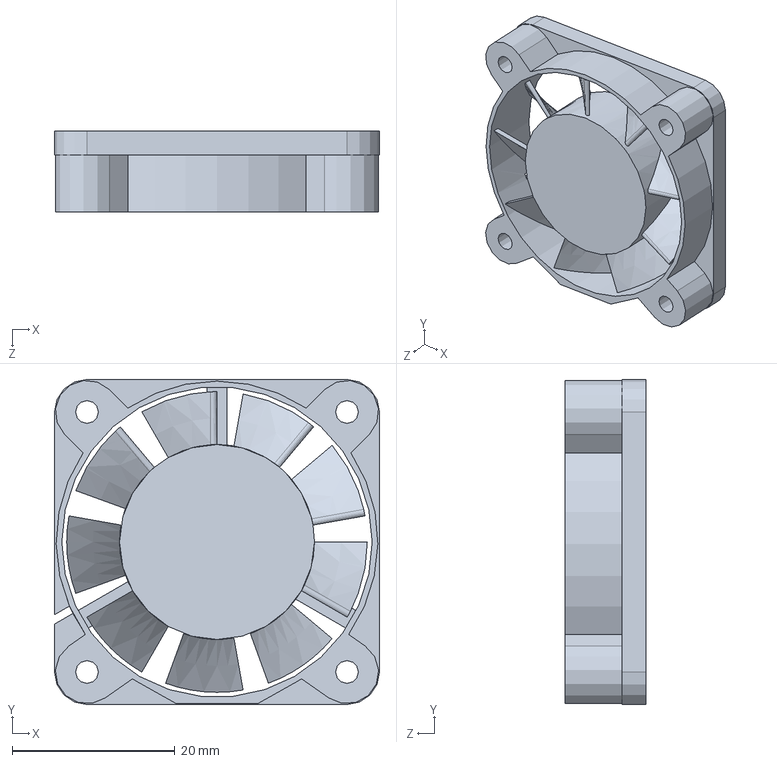
[picture p46: CAD file, 2019-08-08]
Mecanica/Motores/fan 40mm.SLDPRT
40.0 x 40.0 x 10.0 mm
