enriquewph/Impresora-Braille/Mecanica/archivos ultimos/punta/punta.SLDPRT

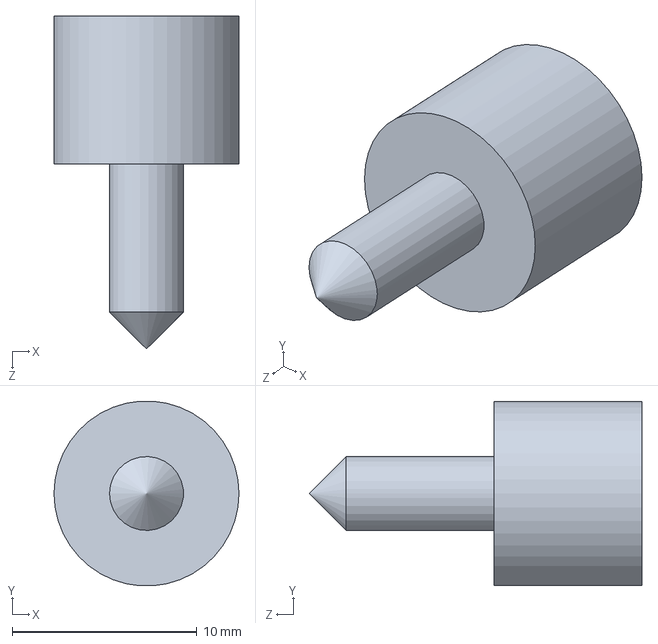
[picture p47: CAD file, 2019-08-08]
Mecanica/archivos ultimos/punta/punta.SLDPRT
10.0 x 9.97 x 18.0 mm
