enriquewph/Impresora-Braille/Mecanica/Motores/Motor continua.SLDPRT

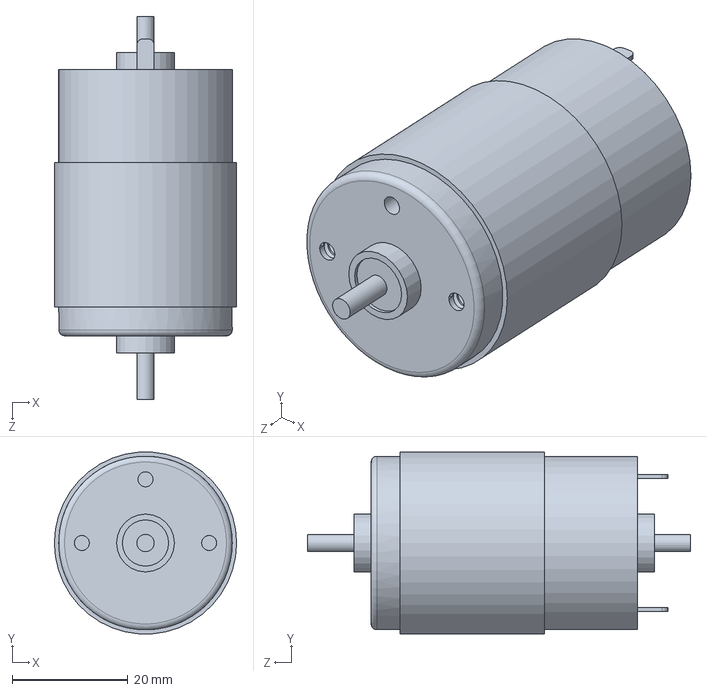
[picture p48: CAD file, 2019-06-14]
Mecanica/Motores/Motor continua.SLDPRT
31.5 x 31.4 x 66.2 mm
