enriquewph/Impresora-Braille/Mecanica/archivos ultimos/SS front.SLDPRT

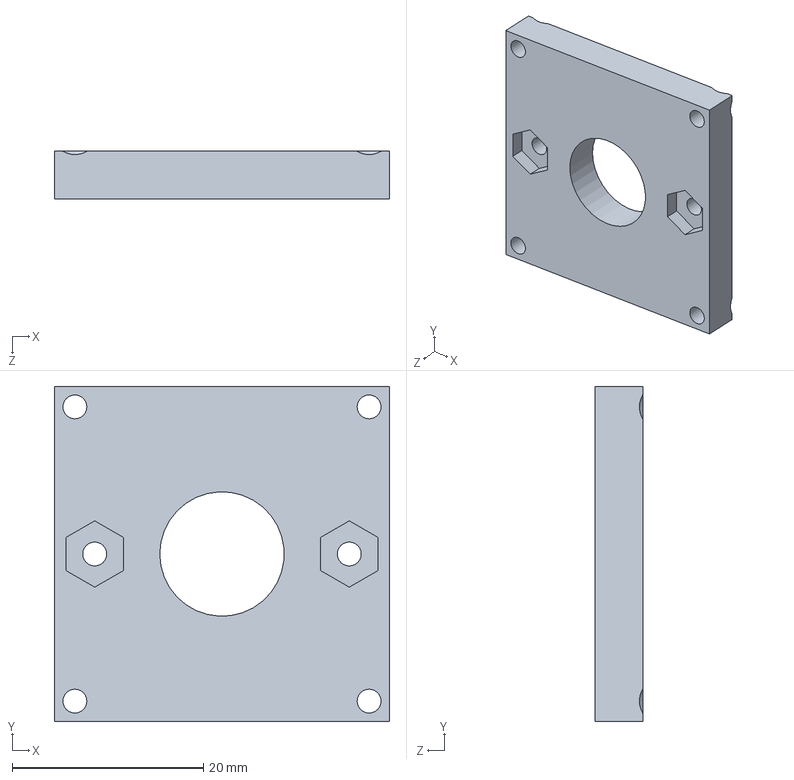
[picture p49: CAD file, 2019-08-08]
Mecanica/archivos ultimos/SS front.SLDPRT
35.0 x 35.0 x 5.00 mm
