enriquewph/Impresora-Braille/Mecanica/impresora/Impresora cuerpo.SLDPRT

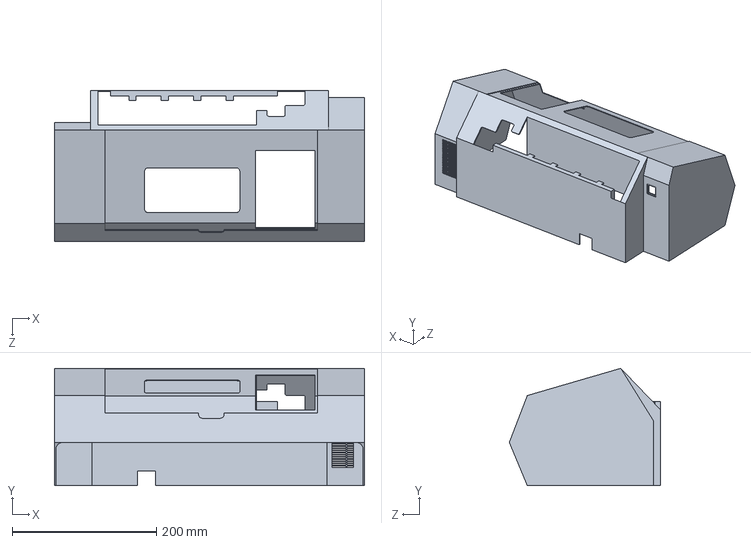
[picture p50: CAD file, 2019-08-08]
Mecanica/impresora/Impresora cuerpo.SLDPRT
430.0 x 162.7 x 210.0 mm
