enriquewph/Impresora-Braille/Mecanica/archivos ultimos/Tapa impresora.SLDPRT

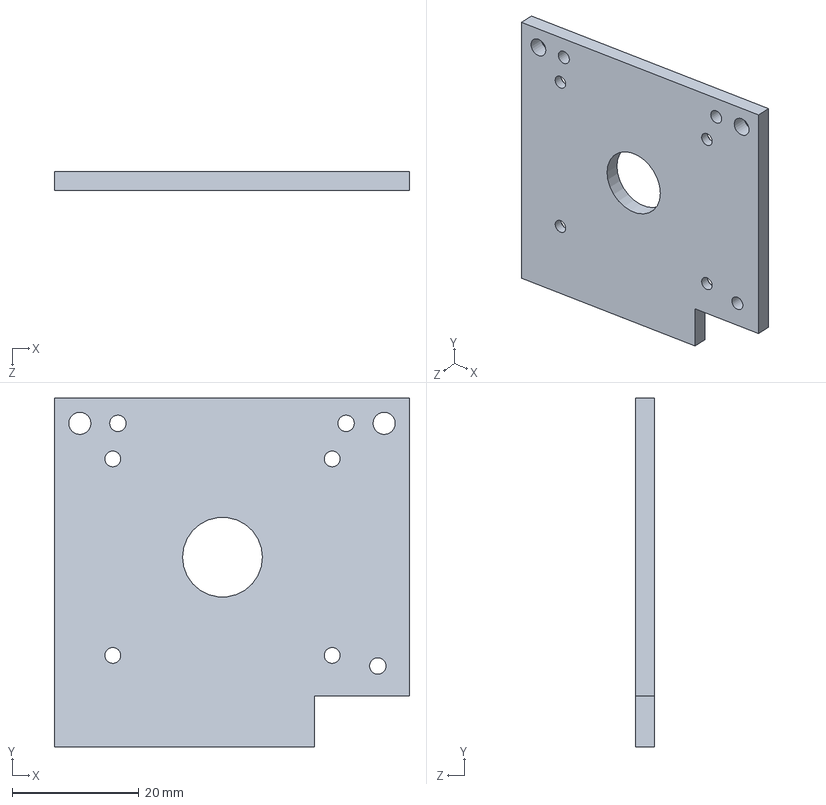
[picture p51: CAD file, 2019-08-08]
Mecanica/archivos ultimos/Tapa impresora.SLDPRT
56.0 x 55.0 x 3.00 mm
