enriquewph/Impresora-Braille/Mecanica/archivos ultimos/TAPITA.SLDPRT

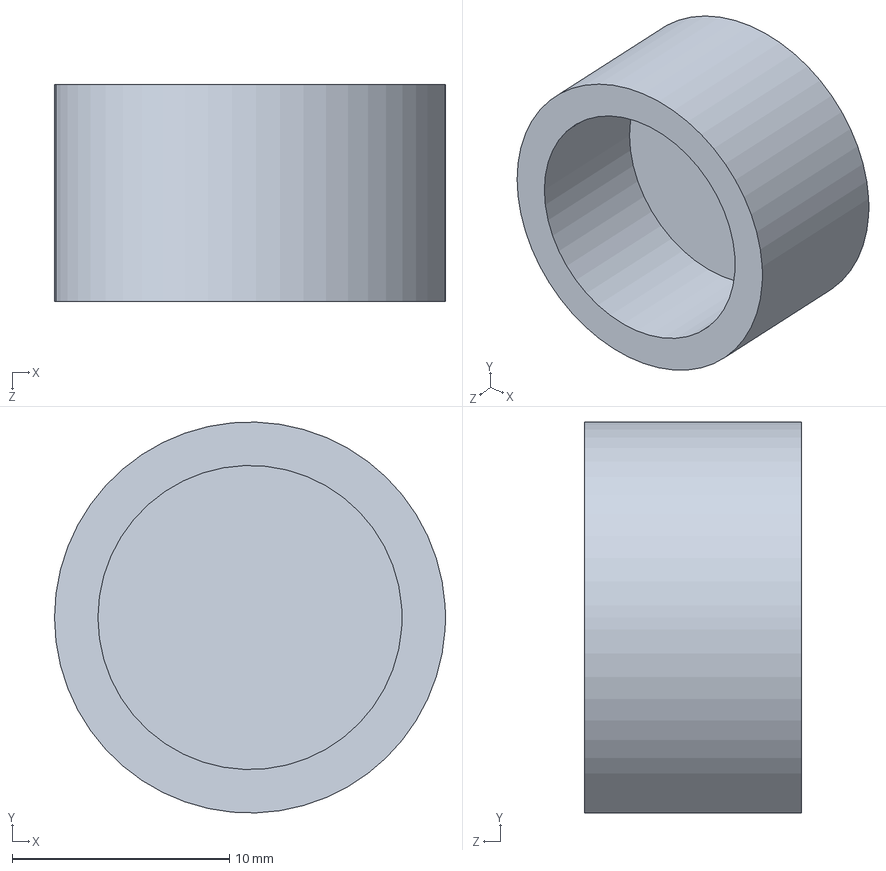
[picture p52: CAD file, 2019-08-08]
Mecanica/archivos ultimos/TAPITA.SLDPRT
18.0 x 18.0 x 10.0 mm
