enriquewph/Impresora-Braille/Mecanica/impresora/Impresora tapa.SLDPRT

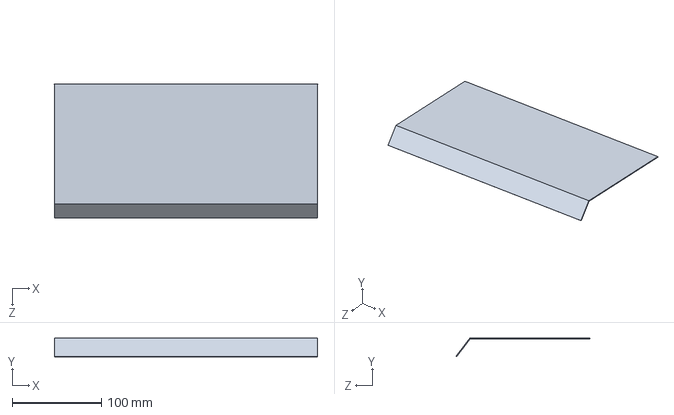
[picture p53: CAD file, 2019-08-08]
Mecanica/impresora/Impresora tapa.SLDPRT
296.0 x 21.1 x 150.6 mm
