enriquewph/Impresora-Braille/Mecanica/archivos ultimos/punzon.SLDPRT

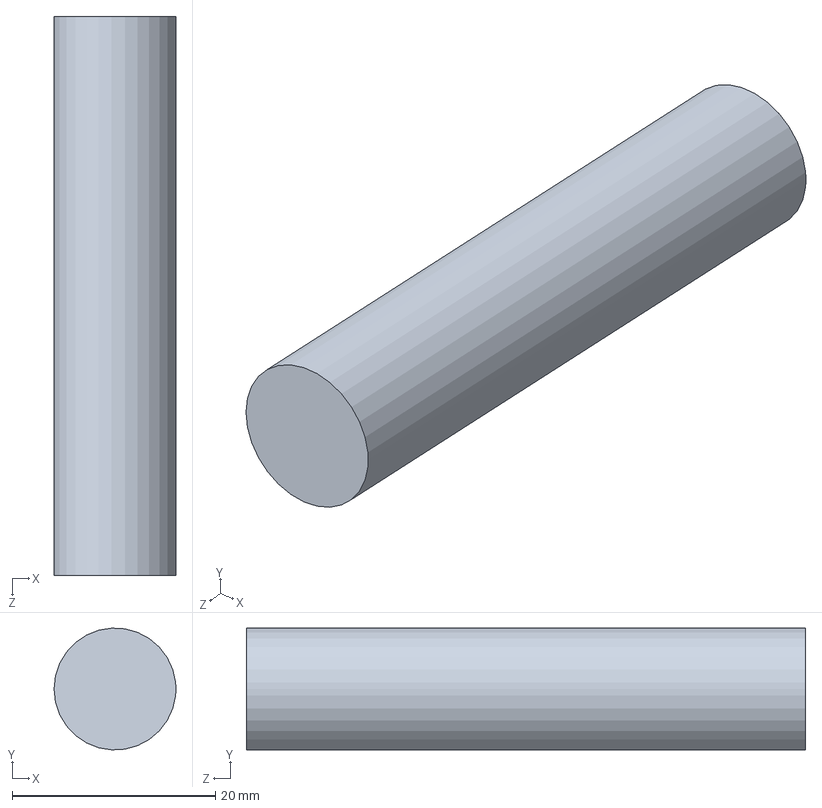
[picture p54: CAD file, 2019-08-08]
Mecanica/archivos ultimos/punzon.SLDPRT
12.0 x 12.0 x 55.0 mm
