enriquewph/Impresora-Braille/Mecanica/impresora/base.SLDPRT

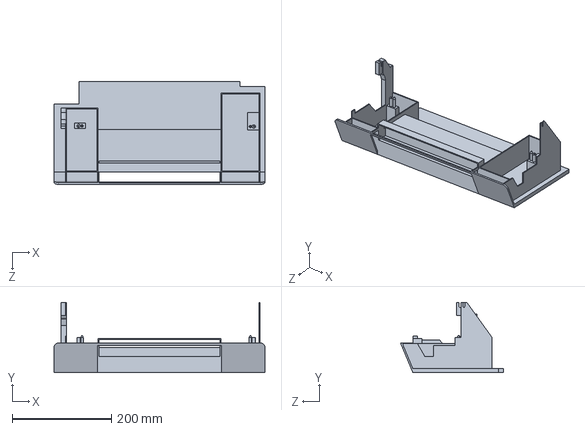
[picture p55: CAD file, 2019-08-08]
Mecanica/impresora/base.SLDPRT
426.0 x 142.0 x 208.0 mm
