enriquewph/Impresora-Braille/Mecanica/archivos ultimos/ss back.SLDPRT

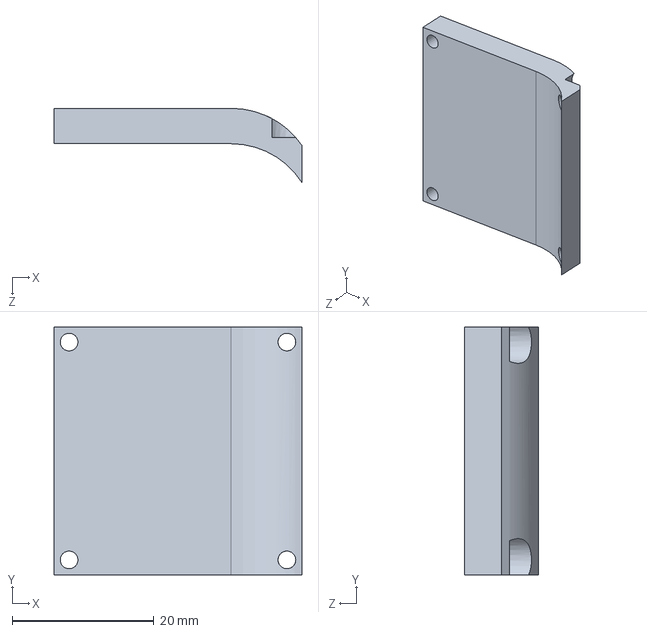
[picture p56: CAD file, 2019-08-08]
Mecanica/archivos ultimos/ss back.SLDPRT
35.0 x 35.0 x 10.5 mm
