enriquewph/Impresora-Braille/Mecanica/archivos ultimos/soporte solenoide.SLDPRT

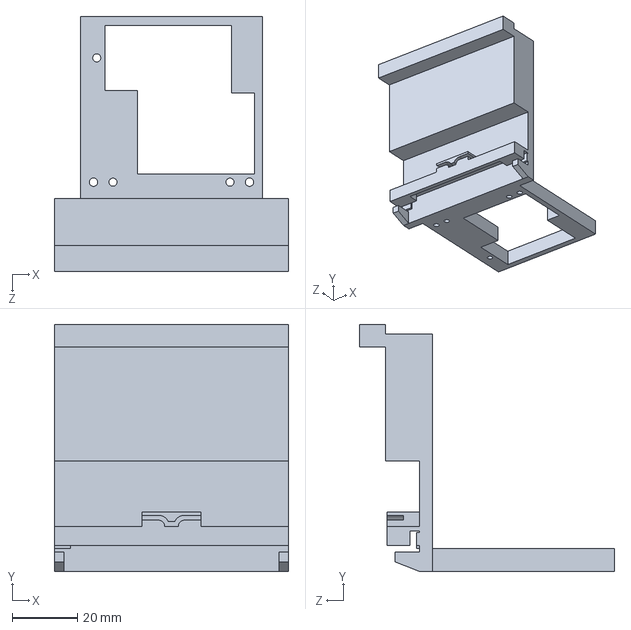
[picture p57: CAD file, 2019-07-30]
Mecanica/archivos ultimos/soporte solenoide.SLDPRT
72.0 x 76.0 x 78.5 mm
