enriquewph/Impresora-Braille/Mecanica/archivos ultimos/SS facil.SLDPRT

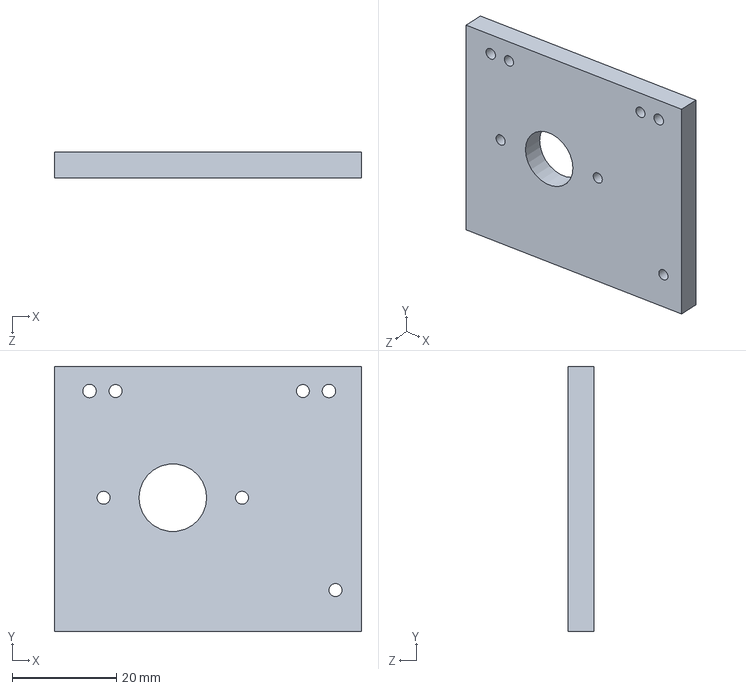
[picture p58: CAD file, 2019-06-14]
Mecanica/archivos ultimos/SS facil.SLDPRT
59.0 x 51.0 x 5.00 mm
