enriquewph/Impresora-Braille/Mecanica/archivos ultimos/solenoide.SLDPRT

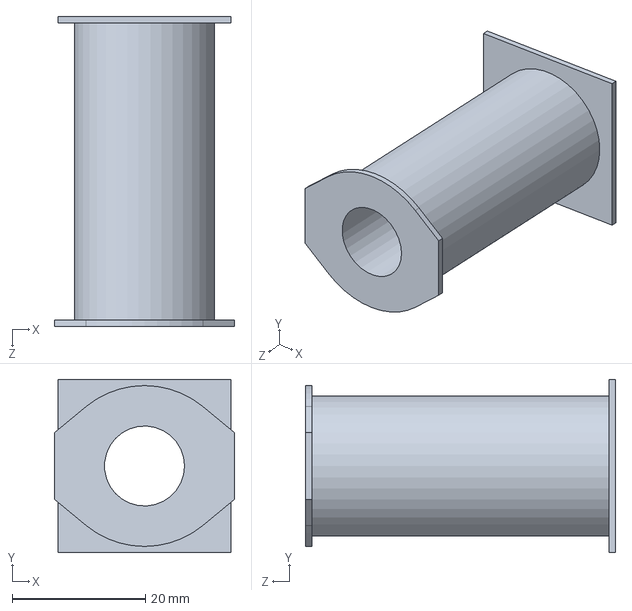
[picture p59: CAD file, 2019-06-14]
Mecanica/archivos ultimos/solenoide.SLDPRT
27.0 x 26.0 x 46.5 mm
