enriquewph/Impresora-Braille/(list of files, cad)

Other CAD files:
Mecanica/archivos ultimos/fan 40mm.SLDPRT
Desarrollo/Mecanica/Estructura/Base.SLDPRT
Desarrollo/Mecanica/Estructura/Corredera.SLDPRT
Desarrollo/Mecanica/Estructura/Ensamblaje1.SLDASM
Desarrollo/Mecanica/Estructura/Impresora asm.SLDASM
Desarrollo/Mecanica/Estructura/Impresora cuerpo.SLDPRT
Desarrollo/Mecanica/Estructura/Impresora tapa.SLDPRT
Desarrollo/Mecanica/Solenoide/SS back.SLDPRT
Desarrollo/Mecanica/Solenoide/SS front.SLDPRT
Desarrollo/Mecanica/Solenoide/SS solenoide esamblaje.SLDPRT.SLDASM
Desarrollo/Mecanica/Solenoide/SS solenoide.SLDPRT
Desarrollo/Mecanica/Solenoide/Tapa impresora.SLDPRT
Mecanica/viejo/Estructura/Base.SLDPRT
Mecanica/viejo/Estructura/Corredera.SLDPRT
Mecanica/viejo/Estructura/Ensamblaje1.SLDASM
Mecanica/viejo/Estructura/Impresora asm.SLDASM
Mecanica/viejo/Estructura/Impresora cuerpo.SLDPRT
Mecanica/viejo/Estructura/Impresora tapa.SLDPRT
Mecanica/viejo/Solenoide/SS back.SLDPRT
Mecanica/viejo/Solenoide/SS front.SLDPRT
Mecanica/viejo/Solenoide/SS solenoide esamblaje.SLDPRT.SLDASM
Mecanica/viejo/Solenoide/SS solenoide.SLDPRT
Mecanica/viejo/Solenoide/Tapa impresora.SLDPRT
