enriquewph/Impresora-Braille/(threads)

Thread 1 (2019-05-10):

Definir parte mecánica:

enriquewph, 2019-05-10:
- [x] Impresora a utilizar.
- [x] Qué motores en cada eje se usaran.
- [ ] Sensores a utilizar y que miden.

GanttStart: 2019-05-17
GanttDue: 2019-05-24

enriquewph, 2019-05-17:
Se partirá de la impresora EPSON STYLUS T23.

enriquewph, 2019-05-17:
Eje X: motor paso a paso OKI EM-546 8Y26ANJ
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

enriquewph, 2019-05-17:
Motor Eje Y: CC
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

enriquewph, 2019-05-17:
Sensor de posicion EJE X
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

enriquewph, 2019-05-17:
Falta info del sensor que detecta cuando termino de pasar la hoja actual.

enriquewph, 2019-06-14:
SENSOR DE FIN DE HOJA:

NOMBRE: **EE-SX1137-P2**

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

Closed 2019-06-14.

Thread 2 (2019-05-10):

Diseño y pruebas de un solenoide

enriquewph, 2019-05-10:
Se debe realizar e implementar un solenoide para que haga los puntos en la hoja.
La alimentación de este sera abierta y cortada por medio de un MOSFET de alta corriente, y podrá ser alimentado con 12V, y los amper que se necesiten para realizar un punto sobre la hoja.

También hay que aplicar un material flexible (Goma Eva o Neopreno) en la parte de abajo donde haría los puntos sobre la hoja.

Se debe establecer una manera fácil para cambiar los solenoides, esto quiere decir que deben tener algún tipo de encastre con el soporte donde irían, aparte al hacerlos de diferentes colores, queda mas fachero.

Mientras sea menos pesado, mejor, la maquina se puede mover más rápido.

- [x] Realizar el diseño de un solenoide.
- [x] Imprimir el carrete.
- [x] Comprar bobinados de diferentes calibres.
- [x] Armar el solenoide.
- [x] Probar el solenoide, verificar consumo y como hace los puntos.
- [x] Refinar diseño.

GanttStart: 2019-05-10
GanttDue: 2019-10-18

enriquewph, 2019-10-18:
@ppnf2 comentá avances, inclui fotos, diseños previos y demas! hay que documentar todo!

Closed 2019-11-27.

Thread 3 (2019-05-10):

Diseño del circuito de control

enriquewph, 2019-05-10:
Se utilizará un ESP-32 WROOVER.
Se debe incluir:
- [x] Fuente switching para 5 y 3.3v
- [x] Entrada y distribución de carriles 12V
- [x] Entrada USB con conversor Serie CH340
- [x] Driver para el mosfet del solenoide
- [x] Driver para motor Paso a paso
- [x] Driver para motor DC
- [x] Entradas de sensores
- [x] Botonera
- [x] Re-programación facil

GanttStart: 2019-05-17
GanttDue: 2019-06-07

enriquewph, 2019-06-03:
info sobre drivers a utilizar:
MARCA TRINAMICS que poseen deteccion de stall, y funciones super silenciosas óptimas para su uso en bibliotecas y otros.
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

[https://ebay.to/2WlCcwK](https://ebay.to/2WlCcwK)

enriquewph, 2019-06-28:
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

Se va a usar ESP32 con arduino para procesar a bajo nivel los movimientos de motores etc con amplia gama de librerias.

[https://github.com/espressif/arduino-esp32](https://github.com/espressif/arduino-esp32)

enriquewph, 2019-06-28:
lib a usar para manejo tarjeta sd https://github.com/espressif/arduino-esp32/tree/master/libraries/SD

enriquewph, 2019-08-20:
hacer:
probar sensor de hoja con 3.3v
probar sensor de posicion x con 3.3v
probar leds con 3.3v para calcular resistencia.
probar salidas del ch340 pines 14 y 13 para ver si son pull a 5v y armar circuito con transistores npn para poner a low el gpio 0 y pin enable para el reset segun esto: https://github.com/espressif/esptool/wiki/ESP32-Boot-Mode-Selection

enriquewph, 2019-08-20:
[SchematicsforESP32.pdf](https://github.com/enriquewph/Impresora-Braille/files/3521317/SchematicsforESP32.pdf)

enriquewph, 2019-08-24:
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

Closed 2019-09-05.

Thread 4 (2019-05-10):

Investigación: Funciones necesarias

enriquewph, 2019-05-10:
Se debe investigar que funciones son indipensables, o por lo menos están presentes en unidades comerciales.

Se debe investigar sobre:
* Diseño de paginas ( Márgenes - Tipografío - Ortografía - Acentos )
* Funciones de software ( Como se imprime, que archivos admite, ¿Se escribe directamente?. Investigar.)

GanttStart: 2019-05-10
GanttDue: 2019-05-17

jmora000, 2019-05-17:
**Formato de Textos**

**L**os textos en braile se escriben de la misma manera que los textos para videntes. Se respetan sangrias y margenes. El formato en el texto ayuda a la comprension del mismo. La fuente es siempre la misma, el tamaño debe ser uniforme, sin ser menor al especificado. Toda informacion que no se pueda traducir se omite (por ejemplo fotos). Una fuente pequeña se percibe como una mancha en relieve, mientras que una demasiado grande puede confundir

**E**l alfabeto braile cuenta con vocales acentuadas, las cuales difieren de las que no. Tambien cuenta con caracteres que ayudan a la comprension del texto, como el caracter mayuscula o numero.

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

**A**demas, existen ciertos caracteres que dan formato a un texto denomidados signos de escritura especial.
**T**odas estas reglas se encuentran expresadas en el siguiente pdf:

[DOCUMENTO TÉCNICO B2 SIGNOGRAFÍA BÁSICA  V1 rev.pdf](https://github.com/enriquewph/Impresora-Braille/files/3191788/DOCUMENTO.TECNICO.B2.SIGNOGRAFIA.BASICA.V1.rev.pdf)

[Caracteristicas_rotulacion_para_personas_con_discapacidad_visual.pdf](https://github.com/enriquewph/Impresora-Braille/files/3191956/Caracteristicas_rotulacion_para_personas_con_discapacidad_visual.pdf)

**C**ontiene todos los caracteres y sus formas de expresion.

**Conversion PDF a Braille**

**L**os traductores de braille funcionan tomando el texto y conviertiendo los caracteres no representables en caracteres traducibles. Por ejemplo: "La casa **blanca**." -> ".la casa 9blanca9'". Luego, estos caracteres ya traducidos se intercambian por su equivalente en braille, cambiando la fuente.

**E**xisten diversor conversores online, pero el mas efectivo es https://www.brailletranslator.org/es.html
Hay que tener en cuenta que no todas las traducciones no son 100% acertadas, ya que las interpretaciones varian segun el contexto

Closed 2019-06-14.

Thread 10 (2019-06-13):

Hacer un archivo para llevar el presupuesto del proyecto.

enriquewph, 2019-06-13:
hacer un google sheets para llevar las cuentas.
agregar lo gastado en compras de 2 impresoras
incluir quien puso la plata al momento de la compra

llevar cuenta de cuanto puso cada uno en compras, efectivo y en componentes/piezas/varios.
llevar cuenta en pesos exclusivamente, si una compra es hecha en dolares, pasarla a pesos al tipo de cambio al momento de compra.

**Incluir lo que yo compre (quique):**

- 2 modulos ESP32-WROOVER por 8.7054 USD a TC: 46.7$
- 2 conectores usb verticales THT por $0.3086 USD a TC 46.7$
- 1 conversor ch340g a $0.4264 USD a TC: 46.7$

_**NOTA LOS PRECIOS DESTACADOS SON TOTALES, NO POR UNIDAD.**_

@jmora000 hace la revision del work de maxi

enriquewph, 2019-06-14:
@maxirivadero dejate menos LGBT y mas formal el doc, falta incluir el coste de compra de dos impresoras.

enriquewph, 2019-06-21:
falta incluir el coste de compra de dos impresoras.

jmora000, 2019-06-21:
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

@enriquewph cuales son los costes de las impresoras

Closed 2019-08-02.

Thread 11 (2019-06-13):

FABRICAR ADAPTADOR ESP-32 URGENTE

enriquewph, 2019-06-13:
**lucas lpm tenes que hacer el adaptador, aca te paso el transfer archivado a este post.**

```
Se debe fabricar un adaptador para el ESP32-WROOVER para una proto

Se adjuntan los archivos de la placa a hacer!
[https://github.com/pcbreflux/espressif/tree/master/esp32/kicad/ESP32-wroover-adapter](https://github.com/pcbreflux/espressif/tree/master/esp32/kicad/ESP32-wroover-adapter)
```

[PCB_ADAPTADOR ESP32-WROVER_EN MIRROR.pdf](https://github.com/enriquewph/Impresora-Braille/files/3435447/PCB_ADAPTADOR.ESP32-WROVER_EN.MIRROR.pdf)

enriquewph, 2019-06-14:
@lucasdavalle fijate si podes hacer esto C:

Closed 2019-08-02.

Thread 7 (2019-06-13):

Cargar comentarios y cosas investigadas/hechas a la wiki.

enriquewph, 2019-06-13:
Jose ponete las pilas capo
GanttStart: 2019-06-13
GanttDue: 2019-10-18

enriquewph, 2019-06-14:
@jmora000  lo de caracteristicas del texto en braille esta joya, en como acceder a el diagrama gantt mirate el comentario que te hize en esa tarea.
En la pagina del presupuesto incluir una foto y dejarlo un poco mas lindo xd fijate si podes insertar la tabla como html o imagen que se actualize automaticamente con plugins de google sheets
@maxirivadero deja menos LGBT el doc del google sheets, un poco mas formal pls xd

@jmora000  en diseño y pruebas de un solenoide cambiar el titulo a "Solenoide: La pieza central"
e incluir imagenes extraidas de los modelos de solidworks.

enriquewph, 2019-06-21:
@jmora000 en diseño y pruebas de un solenoide cambiar el titulo a "Solenoide: La pieza central"
e incluir imagenes extraidas de los modelos de solidworks.
En la pagina del presupuesto incluir una foto y dejarlo un poco mas lindo xd fijate si podes insertar la tabla como html o imagen que se actualize automaticamente con plugins de google sheets
@jmora000 incluir la parte mecanica con detalle de sensores y motores y eso.

jmora000, 2019-06-21:
Oye tranquilo viejo

Enviado desde Correo<https://go.microsoft.com/fwlink/?LinkId=550986> para Windows 10

________________________________
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

jmora000, 2019-06-21:
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

jmora000, 2019-06-21:
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

jmora000, 2019-06-21:
@jmora000 incluir la parte mecanica con detalle de sensores y motores y eso.

Y eso? Lucas me dijo que los sensores dijimos que no

enriquewph, 2019-06-21:
> @jmora000 incluir la parte mecanica con detalle de sensores y motores y eso.
>
> Y eso? Lucas me dijo que los sensores dijimos que no

wut solo inclui mis comentarios en la tarea xd

enriquewph, 2019-09-05:
@jmora000 ahora hay que incluir lo del diseño electronico, con fotos del pcb y esquematico

jmora000, 2019-09-05:
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

Closed 2019-11-12.

Thread 9 (2019-06-13):

elegir y comprar un driver paso a paso

enriquewph, 2019-06-13:
Se debe elegir y comprar un driver para el motor paso a paso.

Se tiene en mente comprar modulos armados del fabricante TRINAMICS ya que poseen los denominados silent step stick que reducen muuucho el ruido del motor paso a paso.
ver video:
[https://www.youtube.com/watch?v=33jQ0P7SMJA](https://www.youtube.com/watch?v=33jQ0P7SMJA)

Vienen diferentes versiones, ver tabla comparativa:
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

Ocupa muy poco espacio.

Se pueden conseguir por ebay
[https://ebay.to/2wRXcfb](https://ebay.to/2wRXcfb)

tambien por mercadolibre: (600$ con envio juju)
[https://articulo.mercadolibre.com.ar/MLA-779246970-1pc-silent-tmc2130-v10-stepper-motor-conductor-modulo-_JM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](https://articulo.mercadolibre.com.ar/MLA-779246970-1pc-silent-tmc2130-v10-stepper-motor-conductor-modulo-_JM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)

enriquewph, 2019-08-02:
se va a ir con el modulo A4988 por su bajo costo, y buen funcionamiento (Franco lo usa en la impresora 3d suya sin problemas y anda bastante bien, Limite de corriente ajustable.)
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
[A4988.pdf](https://github.com/enriquewph/Impresora-Braille/files/3460926/A4988.pdf)

Closed 2019-08-02.

Thread 12 (2019-06-14):

desarrollar driver/buscar driver para motor CC de la impresora

enriquewph, 2019-06-14:
Ver que opciones hay para drivers de motores CC. buscar algo que tenga baja resistencia on y alta eficiencia
idealmente que integren mosfets con RDSon <0.5Ohm

El motor lo vamos a usar a 12v con pwm a 8/10/12/15bit segun haga falta jejejejejjej

fijarse x mercadolibre y tratar de ver que es lo que usa la impresora originalmente.

Considerar que la fuente de la impresora es de como 30v (HAY QUE MEDIRLA TODAVIA), verificar corriente de funcionamiento y corriente de stall

EL DRIVER DEBE INCLUIR UN SENSOR DE CORRIENTE PARA DETECTAR CUANDO SE LLEGO AL EXTREMO DE UN EJE PARA SETEAR LA POSICION X=0!

ppnf2, 2019-07-26:
Driver pap A4988
Driver cc L293d

ppnf2, 2019-07-26:
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

ppnf2, 2019-07-26:
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

enriquewph, 2019-08-02:
se va a ir para el motor CC de la impresora con el integrado DRV8871, en combinacion con un sensor de corriente para sensar cuando el motor se detuvo contra el fin del carrete.
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
[drv8871.pdf](https://github.com/enriquewph/Impresora-Braille/files/3460943/drv8871.pdf)

Closed 2019-08-02.

Thread 13 (2019-06-14):

incluir info acerca del modulo esp32-wroover a usar

enriquewph, 2019-06-14:
jose hacete en la wiki una pagina dedicada al modulo a usar
buscar datasheet, lenguajes de programacion, firmwares disponibles, especificaciones, comparativas entre diferentes modulos ESP-32, identificar tamaño de memoria, resoluciones del ADC, DAC, PWM, velocidad de WIFI, BLUETOOTH, puertos series.

maxirivadero, 2019-07-26:
[ESP32-WROVER_Reference_Design_V4-r2.1.zip](https://github.com/enriquewph/Impresora-Braille/files/3436074/ESP32-WROVER_Reference_Design_V4-r2.1.zip)
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
[esp32-wrover_datasheet_en.pdf](https://github.com/enriquewph/Impresora-Braille/files/3436075/esp32-wrover_datasheet_en.pdf)

Closed 2019-11-27.

Thread 14 (2019-06-14):

incluir visor de gantt en la wiki

enriquewph, 2019-06-14:
@jmora000 hacete un link o una preview para ver el gantt en algún lado de la wiki!

tambien incluile fechas aptas para dejar mas o menos lindo segun consulta a todas las tareas!!!!

entrar a esta pagina:
[https://live.ganttlab.org/?l=me](https://live.ganttlab.org/?l=me)

ahi darle al siguiente icono:
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

pegar el siguiente codigo:

>baef6cb86c95a5a2c60ff98634cfbc1b31d9d647

en el siguiente lugar:
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

y darle al botón azul

gracias josesito xd

enriquewph, 2019-06-14:
@jmora000 fijate de incluir una foto con el remarque hecho con un rectangulo rojo en paint para dejarlo mas prolijo...

jmora000, 2019-06-21:
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

Closed 2019-08-02.

Thread 15 (2019-08-02):

Comprar fuente 12v 6ah

enriquewph, 2019-08-02:
hay que comprar la fuente muchachos, me responden que medidas tiene el trafo y les doy la aprobacion

https://articulo.mercadolibre.com.ar/MLA-741868302-fuente-switching-12v-6a-camaras-cctv-tiras-led-_JM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

hay que ir a buscarla a https://goo.gl/maps/K93CsMrgJ5u8L5Ub8

enriquewph, 2019-08-02:
Las medidas de esa fuente son de 13x5x3cm

enriquewph, 2019-09-05:
se compro una fuente, la quemé yo (@enriquewph )
por lo que compramos otra fuente xd

Closed 2019-09-05.

Thread 16 (2019-08-02):

Armar, en proto, un prototipo

enriquewph, 2019-08-02:
Se debe armar en proto un prototipo con el modulo esp32 la placa adaptadora que fue fabricada, unarduino nano para alimentación y puerto serie, el driver paso a paso en cuestion, e ir probando diferentes firmwares para este.

Closed 2019-09-05.

Thread 17 (2019-09-05):

Implementar control PID eje X

enriquewph, 2019-09-05:
Hay que hacer que el eje X se mueva de manera precisa y rápida, implementando un PID ya que es un sistema con inercia...

GanttStart: 2019-09-05
GanttDue: 2019-10-18

enriquewph, 2019-10-18:
@lucasdavalle hace un comentario para informar el progreso de esto. 6 o 7 renglones. Inclui algun fragmento de codigo o algo

Closed 2019-11-12.

Thread 18 (2019-09-05):

Fabricar una punta para el solenoide

enriquewph, 2019-09-05:
El solenoide debe tener una punta redonda acorde a las dimensiones braille descritas en la foto de abajo
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

GanttStart: 2019-09-05
GanttDue: 2019-10-18

enriquewph, 2019-09-05:
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

ppnf2, 2019-09-05:
![Uploading Nucleo con punta.jpg…]()
![Uploading Resorte nucleo.jpg…]()

ppnf2, 2019-09-05:
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
![Uploading Nucleo con punta.jpg…]()

ppnf2, 2019-09-05:
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

Closed 2019-11-27.

Thread 19 (2019-09-05):

Implementar comunicacion por uart en visual studio para el programa de pc

enriquewph, 2019-09-05:
Se debe establecer un protocolo, y armar una libreria de comunicacion tanto para el visual studio, como para el arduino,
para enviar y recibir respectivamente los siguientes datos:

- Vinculacion y Desvinculacion con la PC
- Numero de hojas a imprimir
- Hoja actual
- Contenido de la hoja actual
- Avisos desde la impresora:
  - Se quedo sin hojas
  - Impresora trabada

GanttStart: 2019-09-05
GanttDue: 2019-10-3

Closed 2019-11-12.

Thread 20 (2019-09-13):

Ensamblar y probar una placa

enriquewph, 2019-09-13:
Ensamblar una placa y realizar las pruebas pertinentes

GanttStart: 2019-09-13
GanttDue: 2019-10-08

enriquewph, 2019-09-13:
Fotos de la placa ensamblada:
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

enriquewph, 2019-09-13:
Resultados de las pruebas:

- LEDS: OK
- FUENTE: OK
- ACS722: OK (Con error, apartado 1)
- CH340G: OK
- TARJETA SD: OK
- DRIVER CC: OK
- DRIVER PASO A PASO: FALTA TESTEAR
- DRIVER COOLER: FAIL
- DRIVER MOSFET: ARREGLADO
- BOTONERA: OK
- ENTRADA ENCODER: FALTA TESTEAR
- ENTRADA S. HOJA: FALTA TESTEAR

enriquewph, 2019-09-30:
Probe la SD en una protoboard y si funciono, probablemente se sobrecalento el ESP32 al soldar, por lo que no anda el GPIO12 y algun pin de la SD
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

Closed 2019-11-12.

Thread 21 (2019-10-18):

Cargar nuevas fotos a la wiki!

enriquewph, 2019-10-18:
Hay que sacar fotos y subirlas, especialmente del nuevo cable flex que implementamos, la posicion del solenoide, la foto y comentario que muestra que este esta lejos del centro y hay que rehacerlo.
Hacer breves comentarios y un comentario general de 6 o 7 renglones comentando todo lo avanzado.

titular a gusto.

GanttStart: 2019-10-18
GanttDue: 2019-10-18

maxirivadero, 2019-10-18:
Se puede observar una vista frontal y trasera de como esta quedando el proyecto.
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
Primero y principal terminamos de diseñar y armar la fuente de alimentación para que pudiéramos empezar a probar el resto de partes de la impresora.
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
Colocamos la placa en la impresora con la cual vamos a controlar la punta que hará los agujeros en el papel
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
Tuvimos un problema con las conexiones debido a que no podiamos cerrar la tapa de la impresora,por lo que tuvimos que desconectar todo y poner un cable flex para que esta cerrara bien.
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
Ahora tenemos un problema con el solenoide,ya que este quedo lejos del centro y afecta a como va imprimirse los textos,por lo que vamos a tener que hacerlo de nuevo.

Closed 2019-11-27.

Thread 22 (2019-10-18):

Incluir fechas para gantt en todas las tareas

enriquewph, 2019-10-18:
Incluir, con las siguientes 2 lineas al final de cada tarea:

GanttStart: 2019-10-18
GanttDue: 2019-10-18

las fechas de inicio y cierre de las tareas adecuadamente,

revisar el historial en cada issue o tarea para conocer estas fechas.

Closed 2019-11-12.

Thread 23 (2019-10-18):

Desarrollar software de PC

enriquewph, 2019-10-18:
Trabajado por @enriquewph

1. El usuario pega/escribe el texto a traducir - Opcionalmente accede a un panel de vista previa en vivo para ver la traduccion mientras escribe
2. El usuario le da al boton de traducir
3. El usuario puede editar y corregir el texto traducido, darle espacios y demas. Poseera de un visor de teclas para ver que atajo del teclado equivale a cada simbolo.
4. El usuario le da al boton de vista previa, el software procesa el texto ya traducido, lo divide en paginas, y lo recorta con dos opciones: cada fin de palabra, o recorte fijo al llegar a 28 caracteres, esto es elegido por el usuario.
5. El usuario vera lo que se va a imprimir y lo editará como en el paso 3 si es necesario
6. El usuario selecciona cantidad de copias e imprimirá.

enriquewph, 2019-10-23:
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

> el software procesa el texto ya traducido, lo divide en paginas, y lo recorta con dos opciones: cada fin de palabra, o recorte fijo al llegar a 28 caracteres, esto es elegido por el usuario.

enriquewph, 2019-11-08:
se debe imprimir todas las hojas hasta el momento que se dio IMPRIMIR.
opcionalmente seleccionar cantidad de copias... (IMPLEMENTAR LUEGO).
hacer panel de impresión, seleccionando la cantidad de copias, o qué hojas se desean imprimir.
Con esto, cargar en TrabajoActual una nueva lista de hojas, para enviar a la impresora.

Ejecutar subrutina para imprimir la primera hoja. Se debe llevar un indice que indique que hoja se está imprimiendo.

Mientras imprime, se reporta el estado desde la impresora seguidamente...

Cuando termine de imprimir la hoja, se debe ejecutar un evento que revise si hay otra hoja para imprimir
si hay otra hoja, ejecutar imprimir() de nuevo, con la hoja en cuestión.

Repetir hasta terminar.

Si falla:
Dar aviso al usuario que algo salió mal.
con la opción de imprimir la hoja actual que se estaba imprimiendo de nuevo y continuar el documento.

enriquewph, 2019-11-25:
agregar consulta pc -> impresora acerca de el estado actual
agregar comandos para abortar impresion
agregar comando para sacar la hoja

Closed 2019-11-27.

Thread 24 (2019-10-25):

Pensar y definir eventos a informar POR la impresora

enriquewph, 2019-10-25:
La impresora se comunicara de vez en cuando con la pc para informar acerca de ciertos eventos como:

- Cuando se termino de imprimir la hoja actual
- cuando falló al imprimir la hoja actual (PENSAR LOS PORQUÉ y COMO DETECTARLOS)
- Cuando se termino de imprimir una linea...

Closed 2019-11-27.

Thread 25 (2020-08-07):

Imagen del proyecto

MartinNievas, 2020-08-07:
Estuve leyendo el proyecto, muy bueno!
Para que sea más visible, estaría bueno un imagen en el README principal, como la que está en la [documentación](https://github.com/enriquewph/Impresora-Braille/blob/master/Documentacion/Dise%C3%B1os%20Graficos/repository-open-graph-template.png)

enriquewph, 2020-08-07:
si jaja tengo que ordenar esto, lo tengo pendiente desde hace un tiempo, por que está medio desastroso
