enriquewph/Impresora-Braille/Electronica/alllayers.pdf

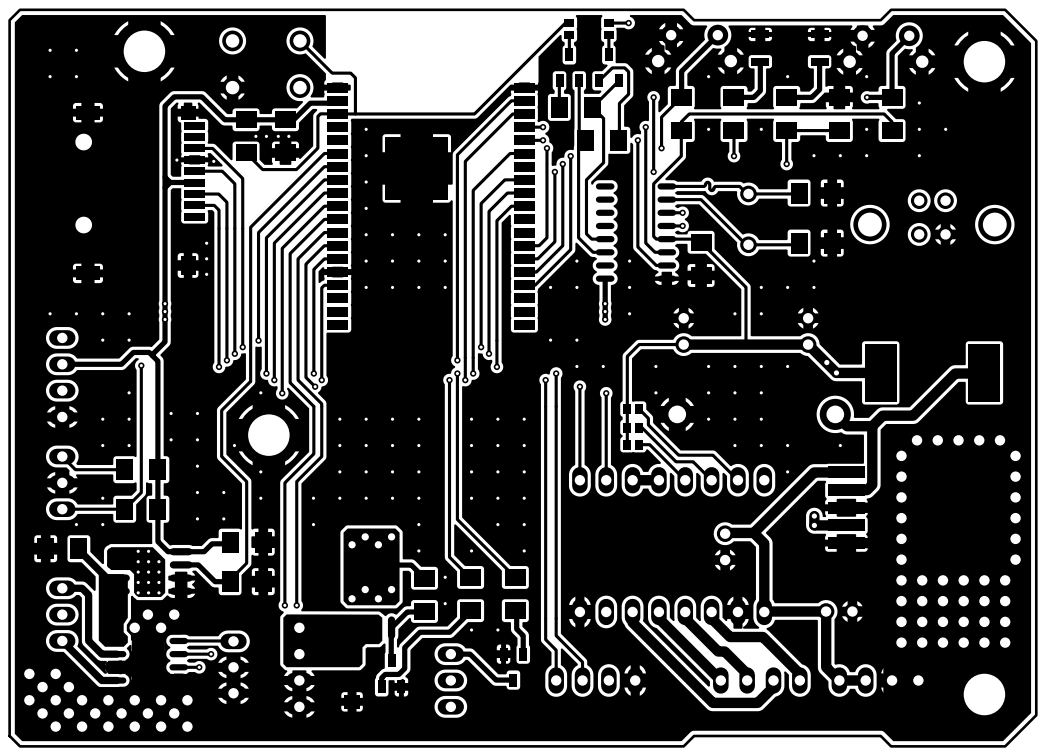
[picture p60: page 1]

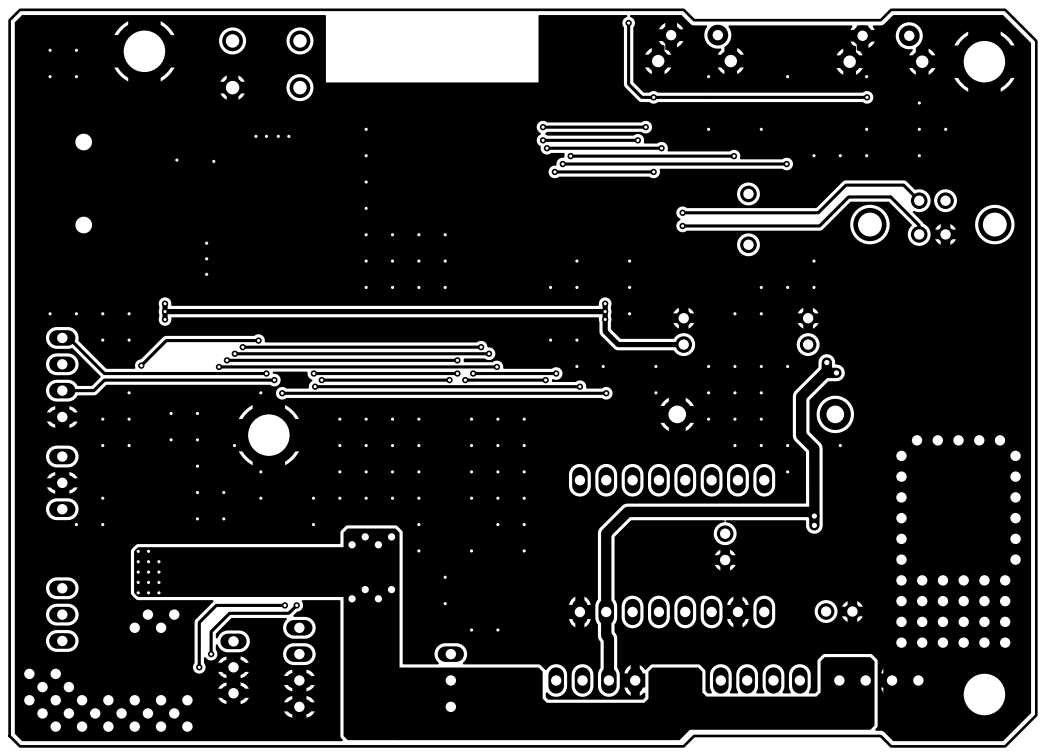
[picture p61: page 2]

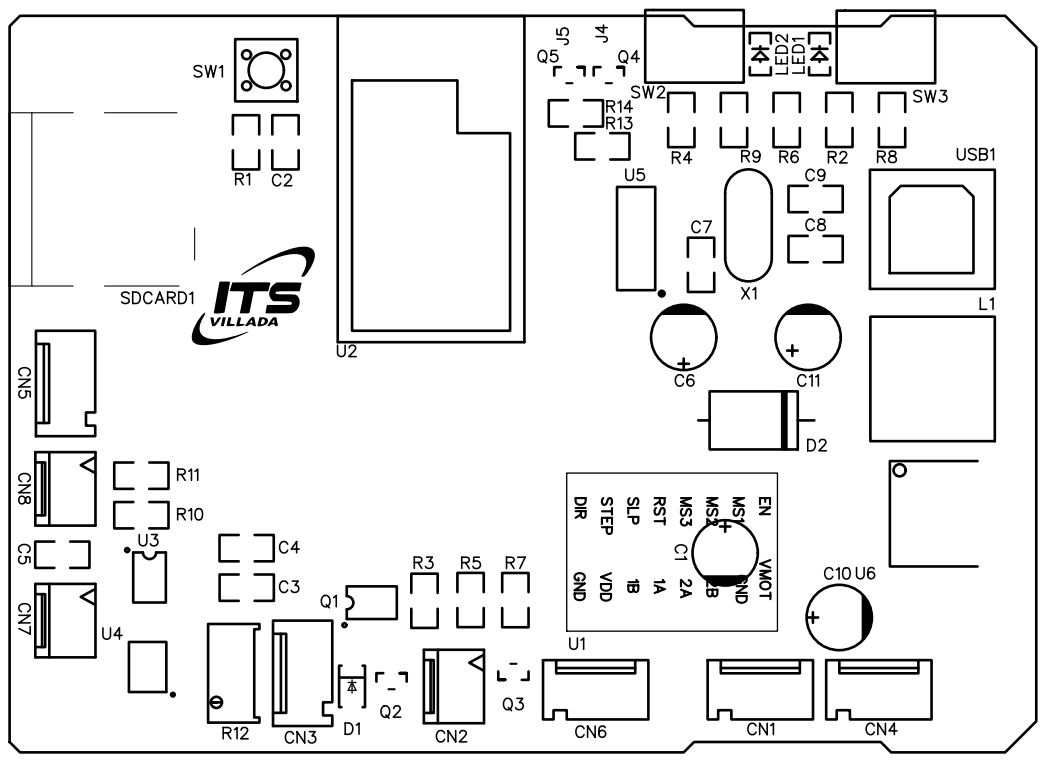
[picture p62: page 3]

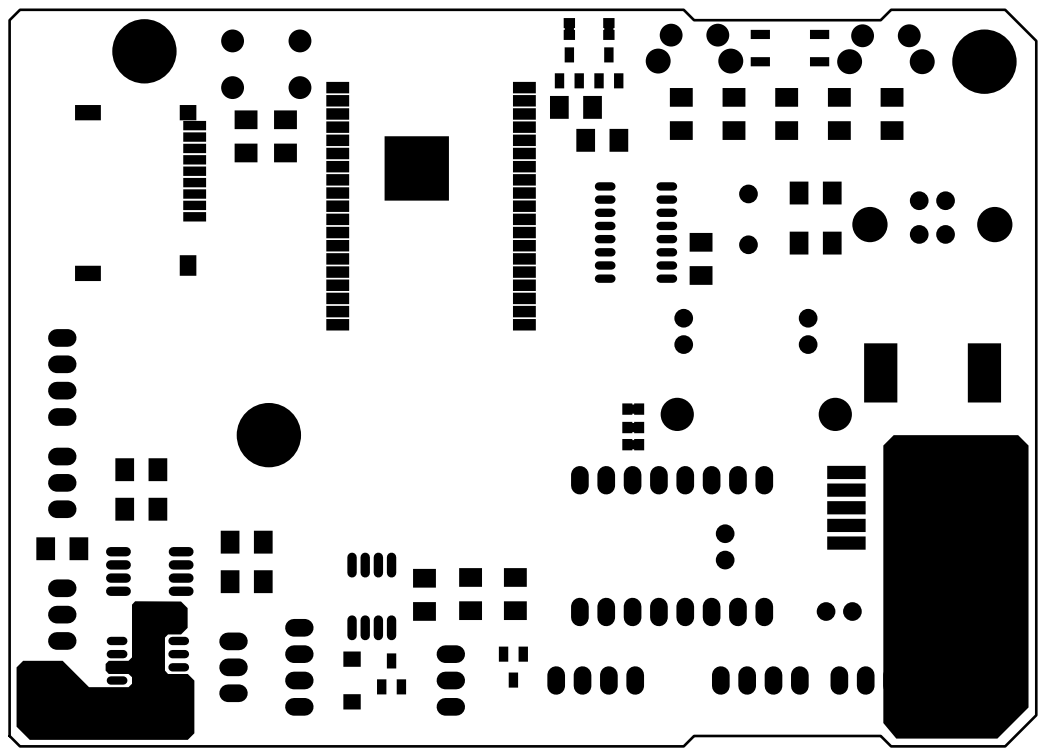
[picture p63: page 7]

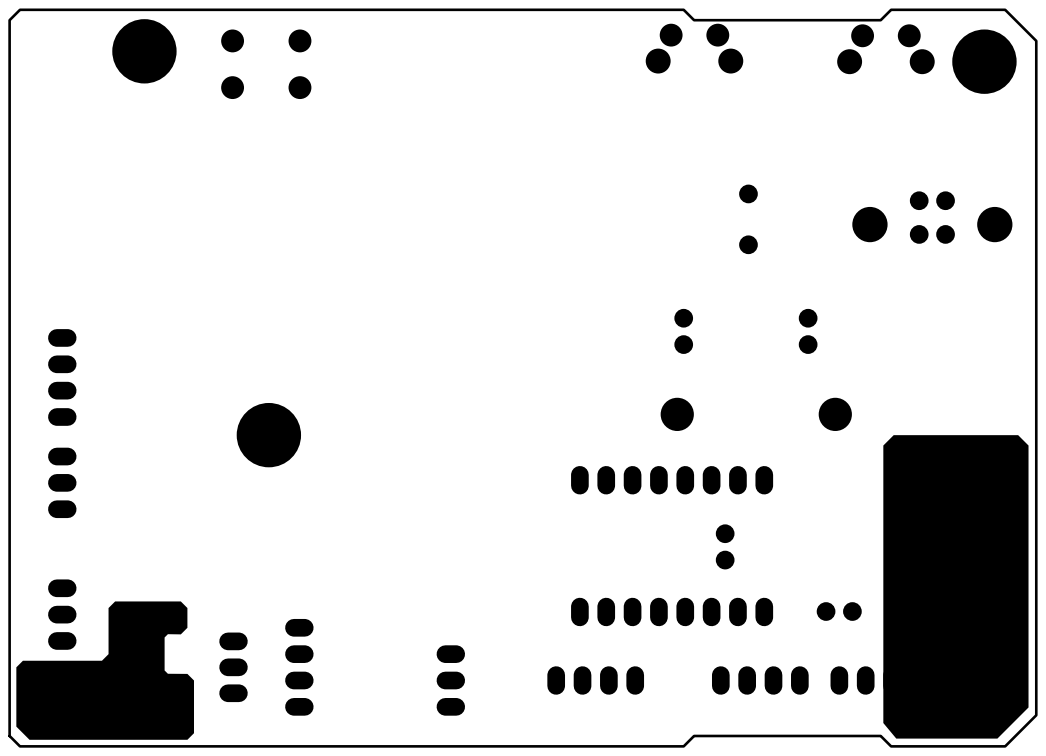
[picture p64: page 8]

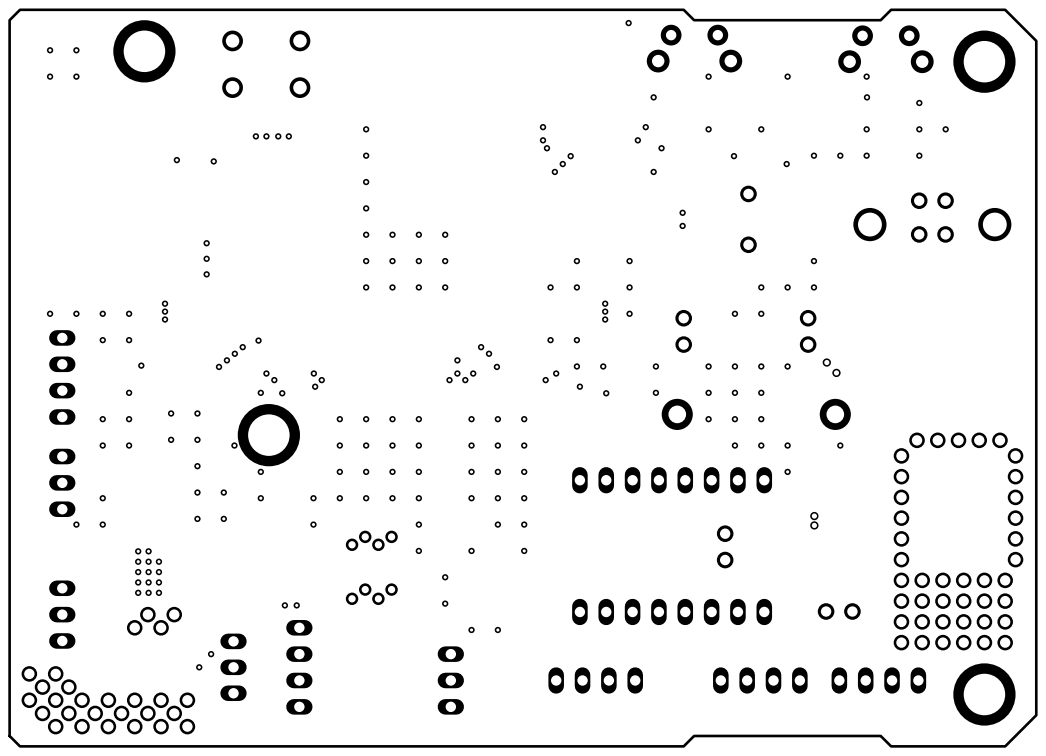
[picture p65: page 10]
