enriquewph/Impresora-Braille/Electronica/artwork.pdf

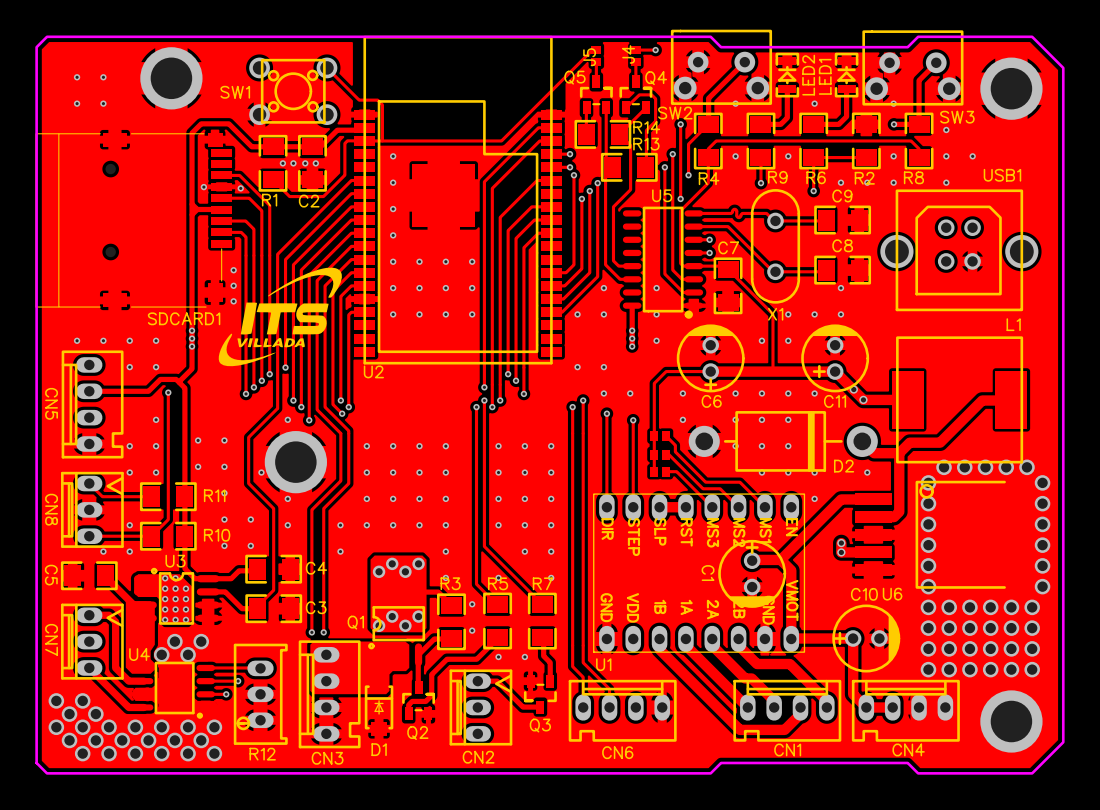
[picture p66: page 1]
