enriquewph/Impresora-Braille/Documentacion/Diseño Solenoide/CALCULOS_SOLENOIDE_FINAL.pdf

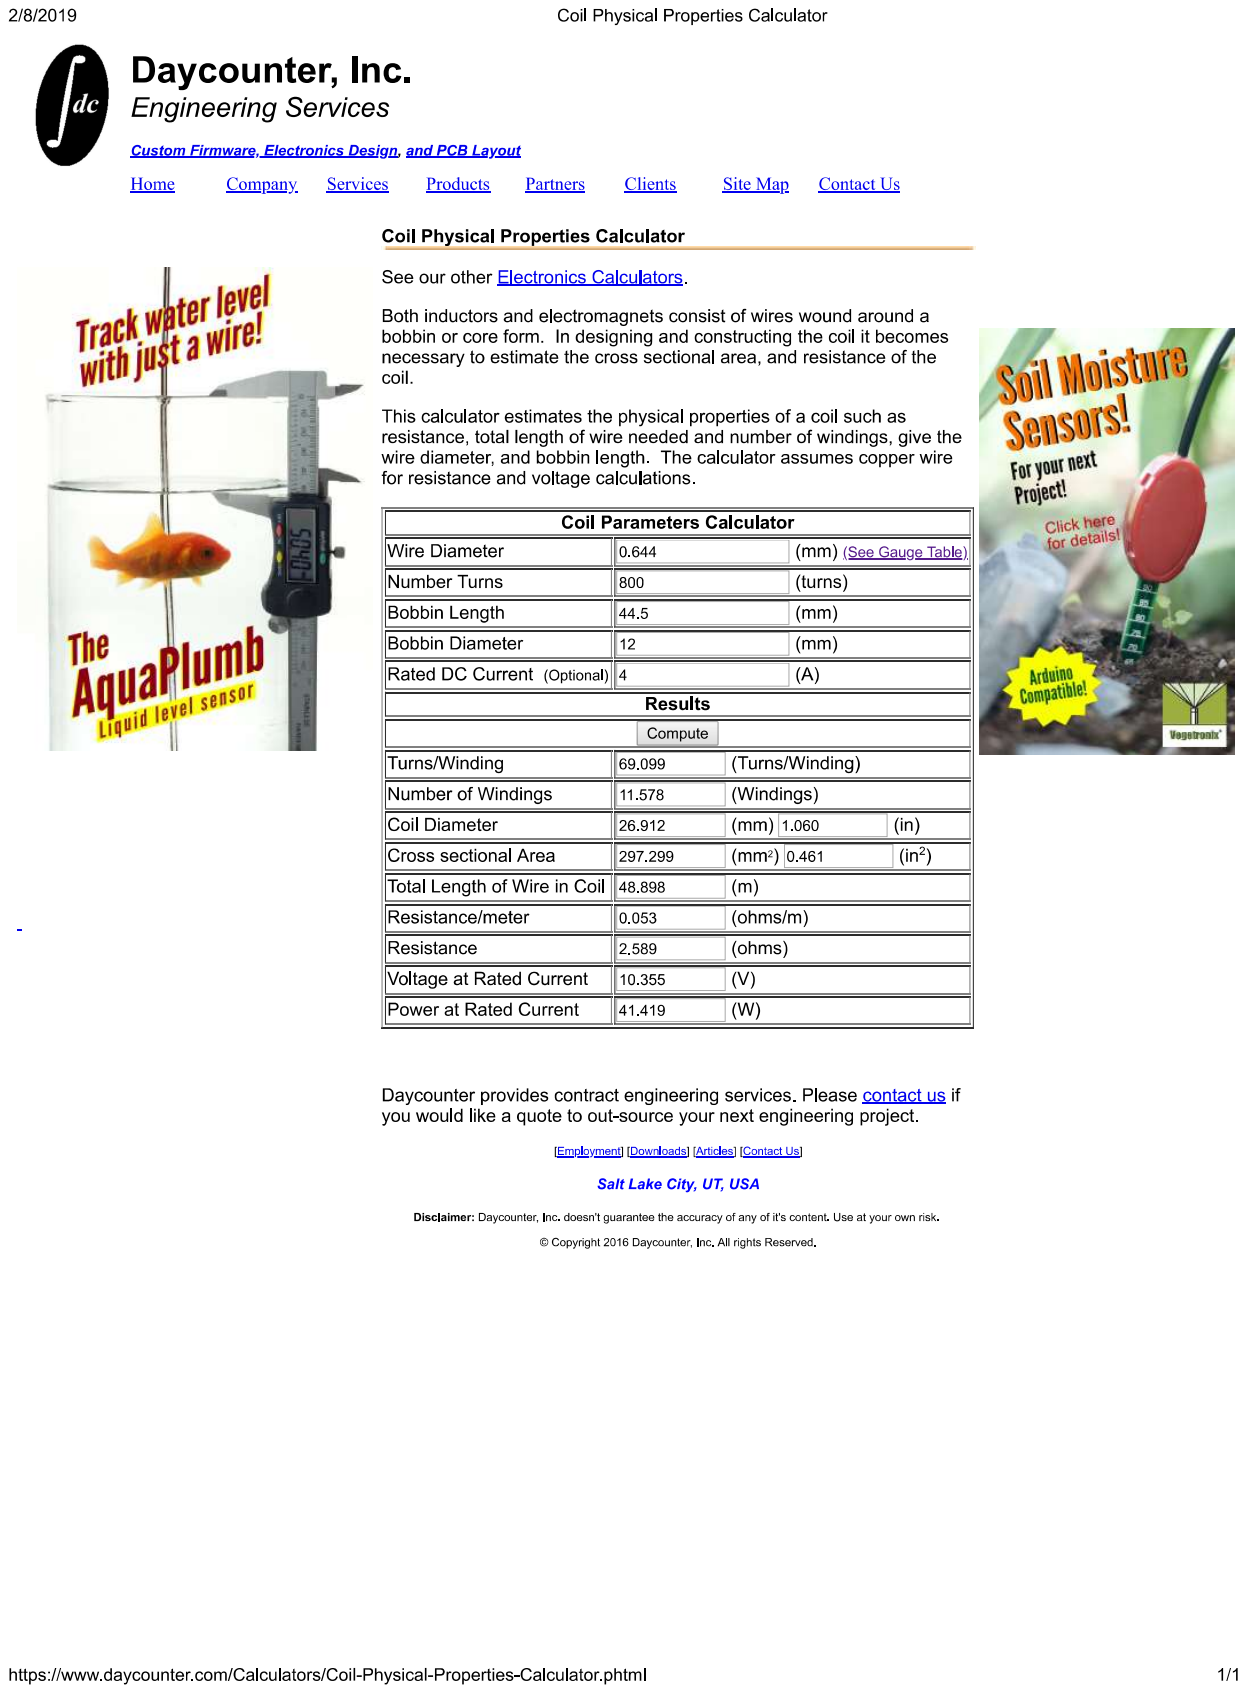
[picture p67: page 1]
