enriquewph/Impresora-Braille/Documentacion/Diseño Solenoide/TABLA_AWG.pdf

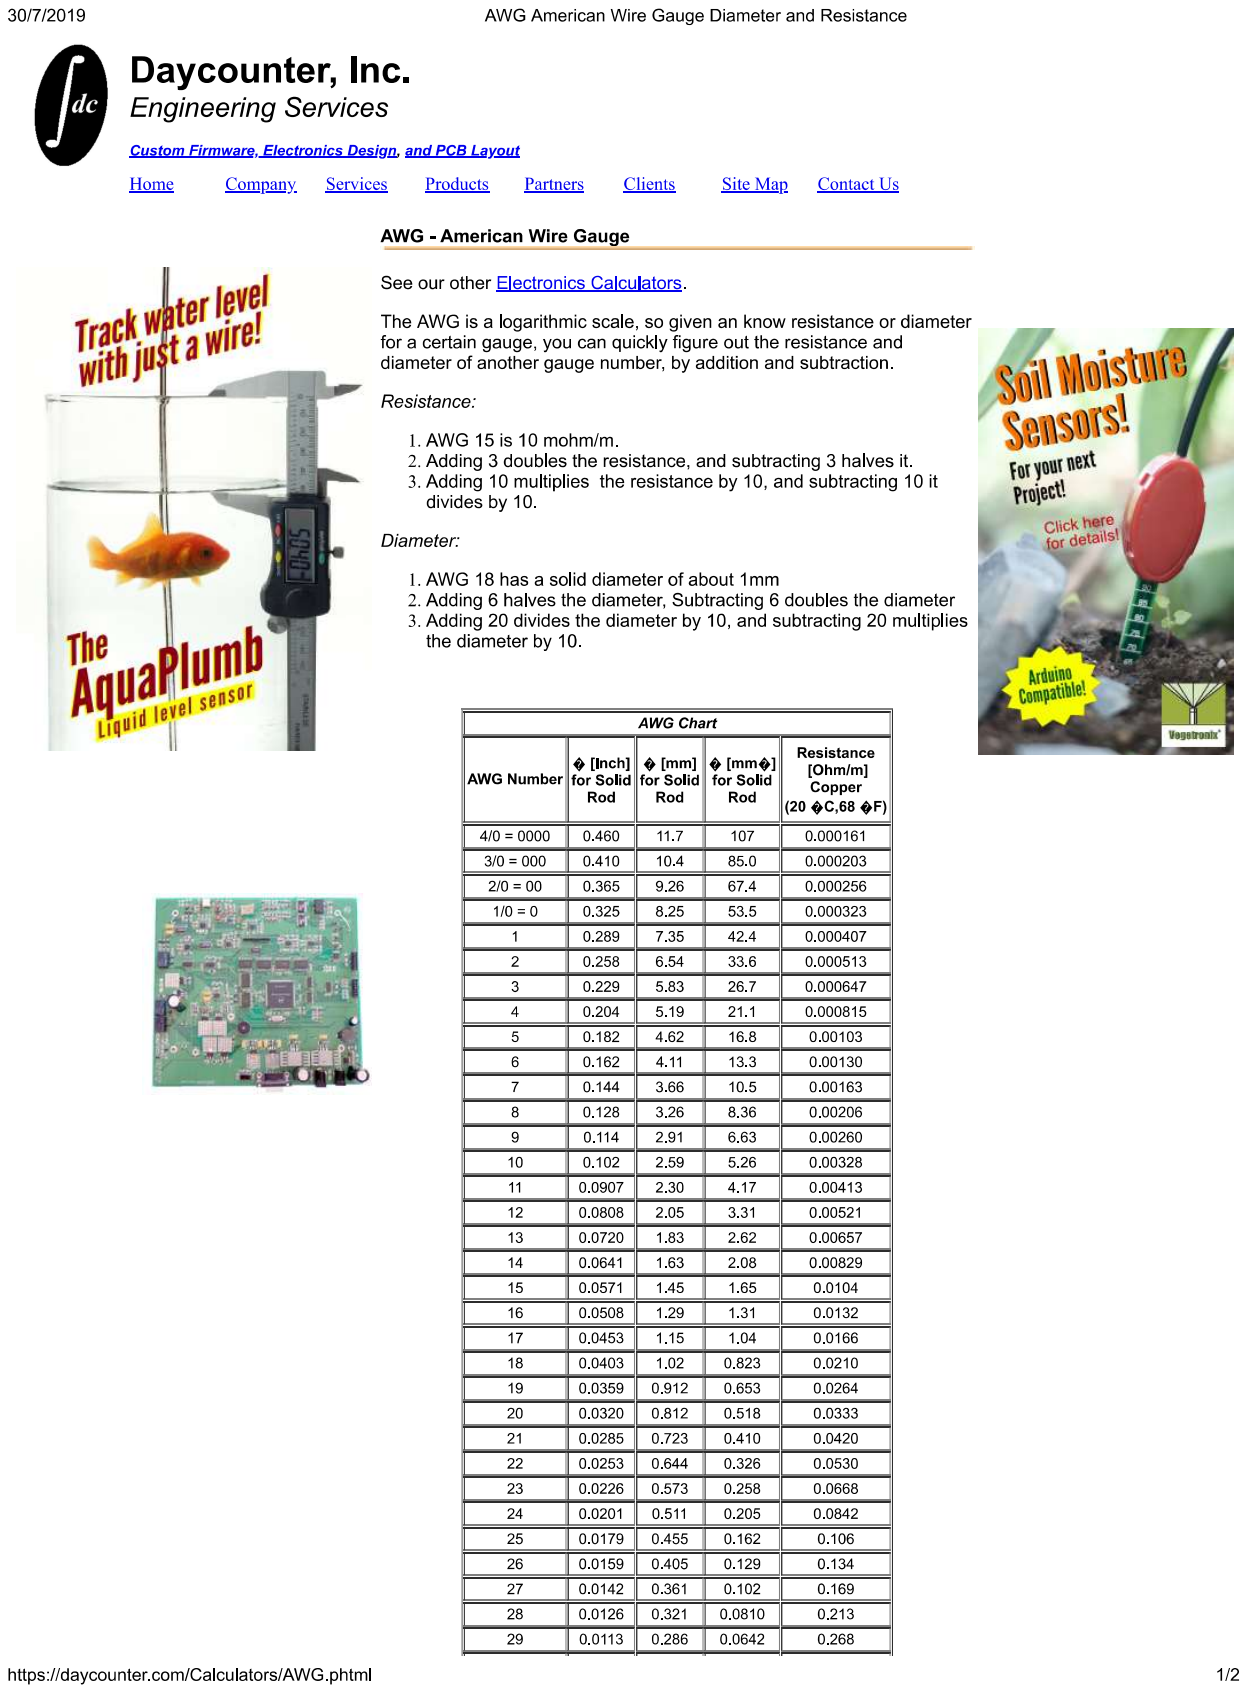
[picture p68: page 1]

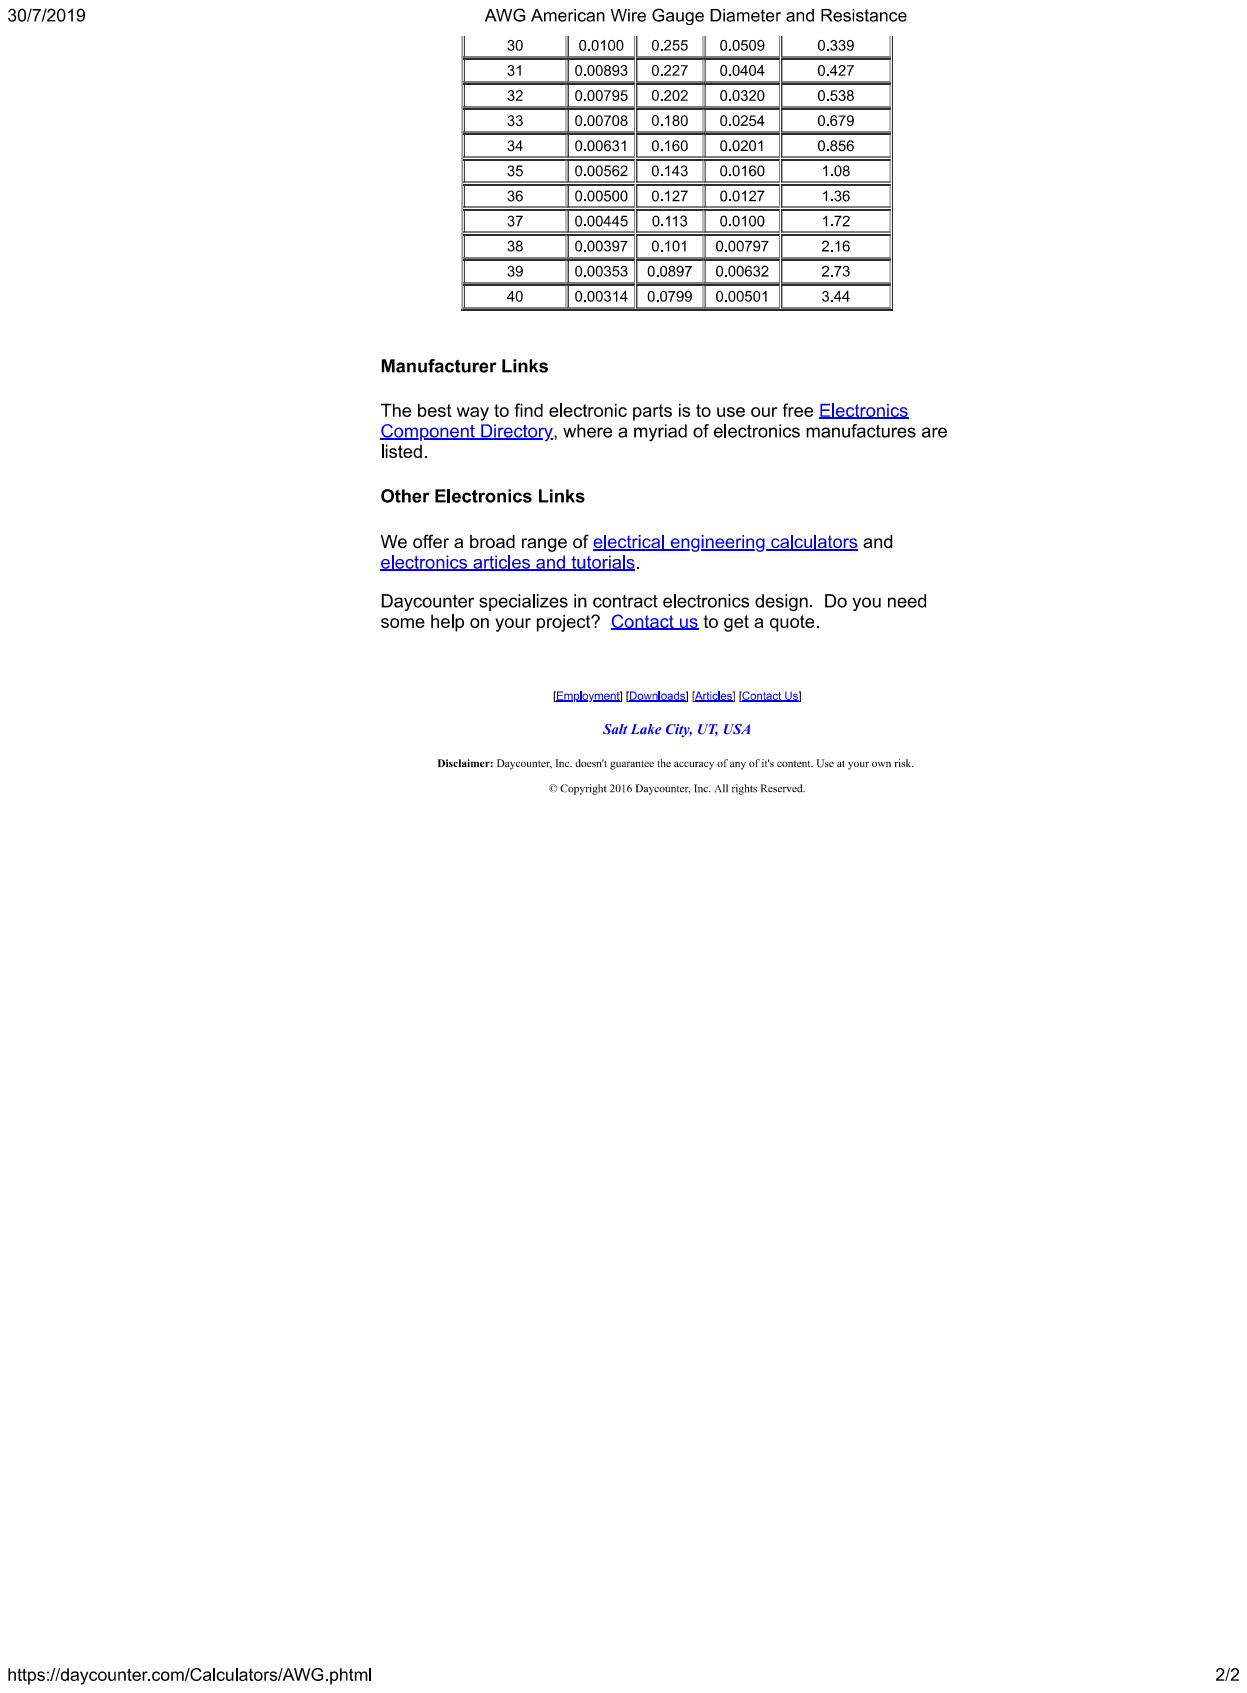
[picture p69: page 2]
