enriquewph/Impresora-Braille/(list of files, drawings)

Other design files:
Electronica/pcb.pcbdoc
