enriquewph/Impresora-Braille/(commit log)

2019-05-10 Actualización de licencia a final
2019-06-01 dibujos iniciales
    [Ensamblaje1.SLDASM, base.SLDPRT, corredera.SLDPRT, motor continua.SLDPRT, solenoide.SLDPRT, soporte solenoide.SLDPRT, ss back.SLDPRT, ss facil.SLDPRT]
2019-06-14 Cambios en modelos 3s
    [Base.SLDPRT, Corredera.SLDPRT, Ensamblaje1.SLDASM, Impresora asm.SLDASM, Impresora cuerpo.SLDPRT, Impresora tapa.SLDPRT, base.SLDPRT, corredera.SLDPRT]
2019-06-14 Archivos varios
    Creo esta carpeta para meter todos los archivos pdf o imagenes que usemos
2019-06-21 Create punzon.SLDPRT
    Archivo que lucas se olvido de pasarme
    [punzon.SLDPRT]
2019-06-28 subido datashit
    [Placa de control.pdsprj]
2019-06-28 Create PCB_ADAPTADOR ESP32-WROVER.pdf
2019-07-30 AGREGADOS TRANSFER-CALCULOS SOLENOIDE
    [Ensamblaje1.SLDASM, Soporte solenoide.SLDPRT, Tapa impresora.SLDPRT]
2019-08-02 subidos documentos nuevos
    [SS front.SLDPRT]
2019-08-08 iniciado el proyecto de arduino
2019-08-08 cargados archivos cad actualizados
    [Base.SLDPRT, Corredera.SLDPRT, Ensamblaje1.SLDASM, Impresora asm.SLDASM, Impresora cuerpo.SLDPRT, Impresora tapa.SLDPRT, Motor continua.SLDPRT, SS back.SLDPRT]
2019-08-16 Cambios en piesas
    [ss solenoide.SLDPRT]
2019-08-24 exportado pcb
    [BOM_Impresora Braille 2019_20190824171446.csv, pcb.pcbdoc, pcb.step]
2019-08-26 subido programa ara calculo y sim switching
2019-09-04 boms subidos
    [BOM_Entrenador Villada 2019_20190827101352.csv, BOM_Impresora Braille 2019_20190827101217.csv]
2019-09-04 subido driver ch340
2019-10-08 subidas boludeces varias
    [BOM_Entrenador Villada 2019_20190827101352.csv, BOM_Impresora Braille 2019_20190827101217.csv]
2019-12-04 la reorganizaition
    [BOM_Entrenador Villada 2019_20190827101352.csv, BOM_Impresora Braille 2019_20190824171446.csv, Base.SLDPRT, Corredera.SLDPRT, Ensamblaje1.SLDASM, Impresora asm.SLDASM, Impresora cuerpo.SLDPRT, Impresora tapa.SLDPRT]
